lizhigang34098/FreeRTOS_UAV/Project_Step_Analysis/13.飞控定高.docx

## 1.1 移植官方文件到interface/fix_height

## 1.2 Vl53l1_platfrom.c

### #include "vl53l1_platform.h"

### #include <string.h>

### #include <time.h>

### #include <math.h>

### int8_t VL53L1_WriteMulti(uint16_t dev, uint16_t index, uint8_t *pdata, uint32_t count)

### {

### return 0; // to be implemented

### }

### int8_t VL53L1_ReadMulti(uint16_t dev, uint16_t index, uint8_t *pdata, uint32_t count)

### {

### return 0; // to be implemented

### }

### int8_t VL53L1_WrByte(uint16_t dev, uint16_t index, uint8_t data)

### {

### // 只写入一个字节

### HAL_I2C_Mem_Write(&hi2c2, dev, index, I2C_MEMADD_SIZE_16BIT, &data, 1, 1000);

### return 0; // to be implemented

### }

### int8_t VL53L1_WrWord(uint16_t dev, uint16_t index, uint16_t data)

### {

### uint8_t data_buf[2] = {0};

### // 使用大端序

### data_buf[0] = data >> 8;

### data_buf[1] = data & 0xFF;

### HAL_I2C_Mem_Write(&hi2c2, dev, index, I2C_MEMADD_SIZE_16BIT, data_buf, 2, 1000);

### return 0; // to be implemented

### }

### int8_t VL53L1_WrDWord(uint16_t dev, uint16_t index, uint32_t data)

### {

### uint8_t data_buf[4] = {0};

### // 使用大端序

### data_buf[0] = data >> 24;

### data_buf[1] = (data >> 16) & 0xFF;

### data_buf[2] = (data >> 8) & 0xFF;

### data_buf[3] = data & 0xFF;

### HAL_I2C_Mem_Write(&hi2c2, dev, index, I2C_MEMADD_SIZE_16BIT, data_buf, 4, 1000);

### return 0; // to be implemented

### }

### int8_t VL53L1_RdByte(uint16_t dev, uint16_t index, uint8_t *data)

### {

### HAL_I2C_Mem_Read(&hi2c2, dev, index, I2C_MEMADD_SIZE_16BIT, data, 1, 1000);

### return 0; // to be implemented

### }

### int8_t VL53L1_RdWord(uint16_t dev, uint16_t index, uint16_t *data)

### {

### // 读取的数据是大端序的

### uint8_t data_buf[2] = {0};

### HAL_I2C_Mem_Read(&hi2c2, dev, index, I2C_MEMADD_SIZE_16BIT, data_buf, 2, 1000);

### *data = (data_buf[0] << 8) | data_buf[1];

### return 0; // to be implemented

### }

### int8_t VL53L1_RdDWord(uint16_t dev, uint16_t index, uint32_t *data)

### {

### uint8_t data_buf[4] = {0};

### HAL_I2C_Mem_Read(&hi2c2, dev, index, I2C_MEMADD_SIZE_16BIT, data_buf, 4, 1000);

### *data = (data_buf[0] << 24) | (data_buf[1] << 16) | (data_buf[2] << 8) | data_buf[3];

### return 0; // to be implemented

### }

### int8_t VL53L1_WaitMs(uint16_t dev, int32_t wait_ms)

### {

### return 0; // to be implemented

### }

## 1.3 Int_VL53L1X.h

### #ifndef __INT_VL53L1X__

### #define __INT_VL53L1X__

### #include "vl53l1_platform.h"

### #include "VL53L1X_api.h"

### #include "VL53L1X_calibration.h"

### #include "FreeRTOS.h"

### #include "task.h"

### /**

### * @brief 初始化激光测距仪 完成寄存器的配置

### */

### void Int_VL53L1X_Init(void);

### /**

### * @brief 读取激光测距仪的距离值

### */

### uint16_t Int_VL53L1X_GetDistance(void);

### #endif // __INT_VL53L1X__

## 1.4 Int_VL53L1X.c

### #include "Int_VL53L1X.h"

### uint16_t dev = 0x52;

### /**

### * @brief 初始化激光测距仪 完成寄存器的配置

### */

### void Int_VL53L1X_Init(void)

### {

### // 1. 重置芯片 => XSHUT引脚拉低再拉高

### HAL_GPIO_WritePin(VX_XSHUT_GPIO_Port, VX_XSHUT_Pin, GPIO_PIN_RESET);

### vTaskDelay(2);

### HAL_GPIO_WritePin(VX_XSHUT_GPIO_Port, VX_XSHUT_Pin, GPIO_PIN_SET);

### vTaskDelay(2);

### uint8_t byteData = 0;

### uint16_t wordData = 0;

### uint8_t sensorState = 0;

### /* Those basic I2C read functions can be used to check your own I2C functions */

### VL53L1_RdByte(dev, 0x010F, &byteData);

### printf("VL53L1X Model_ID: %X\n", byteData);

### VL53L1_RdByte(dev, 0x0110, &byteData);

### printf("VL53L1X Module_Type: %X\n", byteData);

### VL53L1_RdWord(dev, 0x010F, &wordData);

### printf("VL53L1X: %X\n", wordData);

### while (sensorState == 0)

### {

### VL53L1X_BootState(dev, &sensorState);

### vTaskDelay(2);

### }

### printf("Chip booted\n");

### /* This function must to be called to initialize the sensor with the default setting */

### VL53L1X_SensorInit(dev);

### VL53L1X_SetDistanceMode(dev, 2); /* 1=short, 2=long */

### VL53L1X_SetTimingBudgetInMs(dev, 20); /* in ms possible values [20, 50, 100, 200, 500] */

### VL53L1X_SetInterMeasurementInMs(dev, 20); /* in ms, IM must be > = TB */

### printf("VL53L1X Ultra Lite Driver Example running ...\n");

### VL53L1X_StartRanging(dev); /* This function has to be called to enable the ranging */

### }

### /**

### * @brief 读取激光测距仪的距离值

### */

### uint16_t Int_VL53L1X_GetDistance(void)

### {

### uint16_t Distance = 0;

### VL53L1X_GetDistance(dev, &Distance);

### return Distance;

### }

## 1.5 App_flight.h

## #ifndef __APP_FLIGHT__

## #define __APP_FLIGHT__

## #include "math.h"

## #include "Com_debug.h"

## #include "Com_pid.h"

## #include "Int_motor.h"

## #include "Int_VL53L1X.h"

## /**

## * @brief 根据PID的输出值 控制电机

## */

## void App_flight_control_motor(void);

## /**

## * @brief 进入定高功能之后的PID计算

## */

## void App_flight_fix_height_pid_process(void);

## #endif // __APP_FLIGHT__

## 1.6 App_flight.c

#include "App_flight.h"

extern Remote_Data remote_data;

extern Flight_State flight_state;

extern TaskHandle_t com_task_handle;

// 电机结构体

Motor_Struct left_top_motor = {.tim = &htim3, .channel = TIM_CHANNEL_1, .speed = 0};

Motor_Struct left_bottom_motor = {.tim = &htim4, .channel = TIM_CHANNEL_4, .speed = 0};

Motor_Struct right_top_motor = {.tim = &htim2, .channel = TIM_CHANNEL_2, .speed = 0};

Motor_Struct right_bottom_motor = {.tim = &htim1, .channel = TIM_CHANNEL_3, .speed = 0};

// 定高的PID结构体

PID_Struct height_pid = {.kp = -0.60, .ki = 0.00, .kd = -0.20};

// 记录下的定高飞行高度

extern uint16_t fix_height;

/**

* @brief 飞控任务初始化 MPU6050初始化 启动电机

*

*/

void App_flight_init(void)

{

Int_MPU6050_Init();

// 启动电机

Int_motor_start(&left_top_motor);

Int_motor_start(&left_bottom_motor);

Int_motor_start(&right_top_motor);

Int_motor_start(&right_bottom_motor);

// 初始化激光测距仪

Int_VL53L1X_Init();

}

/**

* @brief 根据PID的输出值 控制电机

*

*/

void App_flight_control_motor(void)

{

// 1. 首先判断当前飞机的飞行状态

switch (flight_state)

{

case FIX_HEIGHT:

// 只有定高状态才需要进行定高的PID计算 => 定高同时也需要平稳飞行

left_top_motor.speed = remote_data.thr + gyro_y_pid.output - gyro_x_pid.output + Com_limit(gyro_z_pid.output, 100, -100) + height_pid.output;

left_bottom_motor.speed = remote_data.thr - gyro_y_pid.output - gyro_x_pid.output - Com_limit(gyro_z_pid.output, 100, -100) + height_pid.output;

right_top_motor.speed = remote_data.thr + gyro_y_pid.output + gyro_x_pid.output - Com_limit(gyro_z_pid.output, 100, -100) + height_pid.output;

right_bottom_motor.speed = remote_data.thr - gyro_y_pid.output + gyro_x_pid.output + Com_limit(gyro_z_pid.output, 100, -100) + height_pid.output;

break;

case FAIL:

// 进行故障处理 => 一直处理 到满足条件 修改状态为IDLE

// 6ms => 降低速度2点

left_top_motor.speed -= 2;

left_bottom_motor.speed -= 2;

right_top_motor.speed -= 2;

right_bottom_motor.speed -= 2;

if (left_top_motor.speed <= 0 && left_bottom_motor.speed <= 0 && right_top_motor.speed <= 0 && right_bottom_motor.speed <= 0)

{

// 故障处理完成 电机转速都已经降低为0

xTaskNotifyGive(com_task_handle);

}

break;

default:

break;

}

/**

* @brief 进入定高功能之后的PID计算

*

*/

void App_flight_fix_height_pid_process(void)

{

// 24ms一次

// 1. 填写目标值(按下定高功能时的高度)和测量值(当前激光测距仪得到的高度)

height_pid.desire = fix_height;

height_pid.measure = Int_VL53L1X_GetDistance();

// 2. 进行单环PID计算 得到输出值

Com_PID_Calc(&height_pid);

}

## 1.7 App_receive_data.c

### // 按下定高之后的飞行高度

### extern uint16_t fix_height;

### /**

### * @brief 处理飞机的飞行状态

### */

### void App_process_flight_state(void)

### {

### // 使用状态机逻辑实现

### // 1. 轮询调用判断当前所处的状态

### switch (flight_state)

### {

### case NORMAL:

### // 3. 判断进入定高

### if (remote_data.fix_height == 1)

### {

### flight_state = FIX_HEIGHT;

### remote_data.fix_height = 0;

### // 记录下当前目标的高度

### fix_height = Int_VL53L1X_GetDistance();

### }

### // 4. 判断进入故障失联状态

### if (remote_state == REMOTE_DISCONNECTED)

### {

### flight_state = FAIL;

### }

### break;

### case FIX_HEIGHT:

### // 5. 取消定高

### if (remote_data.fix_height == 1)

### {

### flight_state = NORMAL;

### remote_data.fix_height = 0;

### }

### // 6. 判断故障

### if (remote_state == REMOTE_DISCONNECTED)

### {

### flight_state = FAIL;

### }

### break;

### case FAIL:

### // 7.处理失联故障 缓慢停止电机

### // 等待故障处理完成 => 一直等处理完成 不会出现超时

### ulTaskNotifyTake(pdTRUE, portMAX_DELAY);

### flight_state = IDLE;

### break;

### default:

### break;

### }

### }

## 1.8 App_freeRTOS_Task.c

### void flight_task(void *args)

### {

### // 获取当前的基准时间

### TickType_t xLastWakeTime = xTaskGetTickCount();

### uint8_t count = 0;

### // 一定要先对MPU6050执行初始化操作 => 之后才能读取数据

### App_flight_init();

### while (1)

### {

### // 判断定高

### if (flight_state == FIX_HEIGHT)

### {

### // 才需要计算PID => 激光测距仪的数据采集 20ms一次

### count++;

### if (count >= 4)

### {

### App_flight_fix_height_pid_process();

### count = 0;

### }

### }

### // 根据PID计算的结果 对电机进行控制

### App_flight_control_motor();

### // // 4. 打印激光测距仪得到的距离值

### // uint16_t distance = Int_VL53L1X_GetDistance();

### // debug_printf("distance:%d\r\n", distance);

### vTaskDelayUntil(&xLastWakeTime, FLIGHT_TASK_PERIOD);

### }

### }
