lizhigang34098/FreeRTOS_UAV/Project_Step_Analysis/12.飞控pid控制.docx

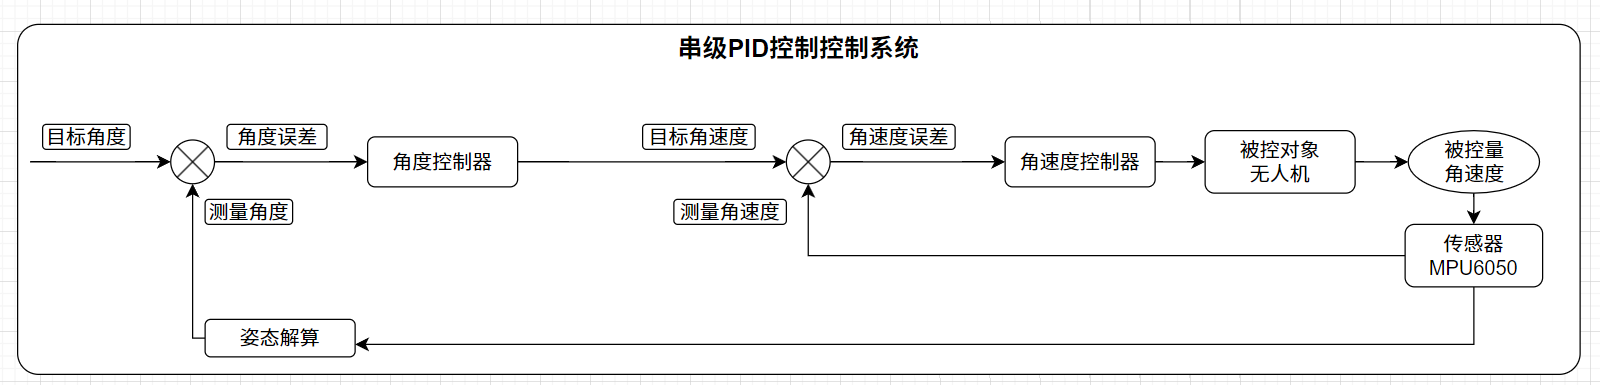
[picture p1: figure]

## 1.1 Com_pid.h

### #ifndef __COM_PID__

### #define __COM_PID__

### #include "main.h"

### #define PID_PERIOD 0.006

### // PID结构体 如果CPU性能够强 推荐使用double

### // kp,ki,kd需要在初始化时确定 目标值和测量值 需要在计算时传递

### typedef struct

### {

### float kp; // 比例部分 值越大响应速度越快

### float ki; // 积分部分 解决稳态误差 无人机控制中 积分项一般不使用

### float kd; // 微分部分 值越大 抑制效果越好 解决过调震荡

### float err; // 误差值

### float desire; // 目标值

### float measure; // 测量值

### float last_err; // 上一次的误差

### float integral; // 积分累积

### float output; // 输出结果

### } PID_Struct;

### // 单次PID计算

### void Com_PID_Calc(PID_Struct *pid);

### // 串级PID计算

### void Com_PID_Calc_Chain(PID_Struct *out_pid, PID_Struct *in_pid);\

### /**

### * @brief 限制数值在正常的范围内

### *

### * @param speed

### * @param max_speed

### * @param min_speed

### * @return int16_t

### */

### int16_t Com_limit(int16_t speed, int16_t max_speed,int16_t min_speed);

### #endif // __COM_PID__

## 1.2 Com_pid.c

### #include "Com_pid.h"

### // 单次PID计算

### void Com_PID_Calc(PID_Struct *pid)

### {

### // 1. 目标和测量 => 计算误差值

### pid->err = pid->measure - pid->desire;

### // 2. 计算积分误差

### pid->integral += pid->err;

### if (pid->last_err == 0)

### {

### pid->last_err = pid->err;

### }

### // 3. 计算微分误差

### float der = pid->err - pid->last_err;

### // 4. 计算输出

### pid->output = pid->kp * pid->err + (pid->ki * pid->integral * PID_PERIOD) + (pid->kd * der / PID_PERIOD);

### // 5. 保存上一次误差

### pid->last_err = pid->err;

### }

### // 串级PID计算

### void Com_PID_Calc_Chain(PID_Struct *out_pid, PID_Struct *in_pid)

### {

### // 1.先计算外环

### Com_PID_Calc(out_pid);

### // 2.将外环的输出值作为内环的目标值

### in_pid->desire = out_pid->output;

### // 3. 计算内环

### Com_PID_Calc(in_pid);

### }

### /**

### * @brief 限制数值在正常的范围内

### *

### * @param speed

### * @param max_speed

### * @param min_speed

### * @return int16_t

### */

### int16_t Com_limit(int16_t speed, int16_t max_speed, int16_t min_speed)

### {

### if (speed > max_speed)

### {

### return max_speed;

### }

### else if (speed < min_speed)

### {

### return min_speed;

### }

### return speed;

### }

## 1.3 App_flight.h

### #ifndef __APP_FLIGHT__

### #define __APP_FLIGHT__

### #include "math.h"

### #include "Com_debug.h"

### #include "Com_filter.h"

### #include "Com_imu.h"

### #include "Com_pid.h"

### #include "Int_motor.h"

### #include "Int_mpu6050.h"

### /**

### * @brief 飞控任务初始化 MPU6050初始化 启动电机

### */

### void App_flight_init(void);

### /**

### * @brief 根据陀螺仪测量的数据 计算出欧拉角

### *

### */

### void App_flight_get_euler_angle(void);

### /**

### * @brief 根据欧拉角 计算出PID的目标值

### */

### void App_flight_pid_process(void);

### /**

### * @brief 根据PID的输出值 控制电机

### */

### void App_flight_control_motor(void);

### #endif // __APP_FLIGHT__

## 1.4 App_flight.c

### #include "App_flight.h"

### Gyro_Accel_Struct gyro_accel_data = {0};

### Euler_struct euler_angle = {0};

### Gyro_struct last_gyro = {0};

### float gyro_z_sum = 0;

### extern Remote_Data remote_data;

### extern Flight_State flight_state;

### // 电机结构体

### Motor_Struct left_top_motor = {.tim = &htim3, .channel = TIM_CHANNEL_1, .speed = 0};

### Motor_Struct left_bottom_motor = {.tim = &htim4, .channel = TIM_CHANNEL_4, .speed = 0};

### Motor_Struct right_top_motor = {.tim = &htim2, .channel = TIM_CHANNEL_2, .speed = 0};

### Motor_Struct right_bottom_motor = {.tim = &htim1, .channel = TIM_CHANNEL_3, .speed = 0};

### // PID的调参是先调节内环再调节外环

### // 俯仰角PID结构体 => 后续需要进行专业的PID调参

### PID_Struct pitch_pid = {.kp = -7.00, .ki = 0.00, .kd = 0.00};

### // Y轴角速度结构体 => 对应俯仰角的内环

### // 极性问题 => 参数的正负可以调节 => 作用于电机的时候 正负

### PID_Struct gyro_y_pid = {.kp = 3.00, .ki = 0.00, .kd = 0.50};

### // 横滚角PID结构体

### PID_Struct roll_pid = {.kp = -7.00, .ki = 0.00, .kd = 0.00};

### // X轴角速度结构体 => 对应横滚角角的内环

### PID_Struct gyro_x_pid = {.kp = 3.00, .ki = 0.00, .kd = 0.50};

### /**

### * @brief 飞控任务初始化 MPU6050初始化 启动电机

### *

### */

### void App_flight_init(void)

### {

### Int_MPU6050_Init();

### // 启动电机

### Int_motor_start(&left_top_motor);

### Int_motor_start(&left_bottom_motor);

### Int_motor_start(&right_top_motor);

### Int_motor_start(&right_bottom_motor);

### }

### /**

### * @brief 根据欧拉角 计算出PID的目标值

### *

### */

### void App_flight_pid_process(void)

### {

### // 俯仰角

### // 1. 需要赋值目标值和测量值

### // 外环的目标角度 => 如果是平稳飞行 => 值为0 => 如果需要遥控飞行 => 目标角度就是遥控器的值

### // 数值转换 => remote_data.pit(0-1000,500为中间点) 控制范围在±10°

### pitch_pid.desire = (remote_data.pit - 500) / 50.0;

### // 内环的测量值 => 就是当前的俯仰角

### pitch_pid.measure = euler_angle.pitch;

### // 外环的测量值 => 当前的角速度 => 单位要保持一致

### gyro_y_pid.measure = (gyro_accel_data.gyro.gyro_y * 2000.0 / 32768.0);

### // 2. 进行PID计算

### Com_PID_Calc_Chain(&pitch_pid, &gyro_y_pid);

### // 先观察内环 => 角速度控制 => 目标位角速度为0

### // debug_printf(":%.2f,%.2f\n", gyro_y_pid.err, gyro_y_pid.output);

### // 横滚角

### // 1. 需要赋值目标值和测量值

### // 外环的目标角度 => 如果是平稳飞行 => 值为0 => 如果需要遥控飞行 => 目标角度就是遥控器的值

### roll_pid.desire = (remote_data.rol - 500) / 50.0;

### // 内环的测量值

### roll_pid.measure = euler_angle.roll;

### // 外环的测量值

### gyro_x_pid.measure = (gyro_accel_data.gyro.gyro_x * 2000.0 / 32768.0);

### // 2. 进行PID计算

### Com_PID_Calc_Chain(&roll_pid, &gyro_x_pid);

### }

### /**

### * @brief 根据PID的输出值 控制电机

### */

### void App_flight_control_motor(void)

### {

### // 1. 首先判断当前飞机的飞行状态

### switch (flight_state)

### {

### case IDLE:

### // 一旦进入加锁状态 => 需要将电机速度设置为0

### left_top_motor.speed = 0;

### left_bottom_motor.speed = 0;

### right_top_motor.speed = 0;

### right_bottom_motor.speed = 0;

### break;

### case NORMAL:

### // 俯仰角 => 向前飞有角速度 => 正误差 => 需要一个向后飞的反馈效果 => 前两个电机转的快 后两个转的慢

### left_top_motor.speed = remote_data.thr + gyro_y_pid.output - gyro_x_pid.output;

### left_bottom_motor.speed = remote_data.thr - gyro_y_pid.output - gyro_x_pid.output;

### right_top_motor.speed = remote_data.thr + gyro_y_pid.output + gyro_x_pid.output;

### right_bottom_motor.speed = remote_data.thr - gyro_y_pid.output + gyro_x_pid.output;

### break;

### case FIX_HEIGHT:

### break;

### case FAIL:

### break;

### default:

### break;

### }

### // 限制电机速度的上限值

### left_top_motor.speed = Com_limit(left_top_motor.speed, 600, 0);

### left_bottom_motor.speed = Com_limit(left_bottom_motor.speed, 600, 0);

### right_top_motor.speed = Com_limit(right_top_motor.speed, 600, 0);

### right_bottom_motor.speed = Com_limit(right_bottom_motor.speed, 600, 0);

### // 安全限制 => 当油门设置为<50时 => 强制将速度设置为0

### if (remote_data.thr < 50)

### {

### left_top_motor.speed = 0;

### left_bottom_motor.speed = 0;

### right_top_motor.speed = 0;

### right_bottom_motor.speed = 0;

### }

### // 2. 设置电机速度

### Int_motor_set_speed(&left_top_motor);

### Int_motor_set_speed(&left_bottom_motor);

### Int_motor_set_speed(&right_top_motor);

### Int_motor_set_speed(&right_bottom_motor);

### }

## 1.5 App_freeRTOS_Task.c

### #include "App_freeRTOS_Task.h"

### // 表示当前的飞行状态

### Flight_State flight_state = IDLE;

### /

### // 飞行控制任务

### void flight_task(void *args);

### #define FLIGHT_TASK_STACK_SIZE 128

### #define FLIGHT_TASK_PRIORITY 3

### TaskHandle_t flight_task_handle;

### #define FLIGHT_TASK_PERIOD 6

### /**

### * @brief 启动freeRTOS操作系统

### */

### void App_freeRTOS_start(void)

### {

### // 创建飞行控制任务

### xTaskCreate(flight_task, "flight_task", FLIGHT_TASK_STACK_SIZE, NULL, FLIGHT_TASK_PRIORITY, &flight_task_handle);

### // 启动调度器

### vTaskStartScheduler();

### }

### void flight_task(void *args)

### {

### // 获取当前的基准时间

### TickType_t xLastWakeTime = xTaskGetTickCount();

### // 一定要先对MPU6050执行初始化操作 => 之后才能读取数据

### App_flight_init();

### while (1)

### {

### // 1. 获根据MPU6050测量的数据 姿态解算得到欧拉角

### App_flight_get_euler_angle();

### // 2. 根据当前的欧拉角 进行PID计算控制

### App_flight_pid_process();

### // 3. 根据PID计算的结果 对电机进行控制

### App_flight_control_motor();

### vTaskDelayUntil(&xLastWakeTime, FLIGHT_TASK_PERIOD);

### }

### }
