lizhigang34098/FreeRTOS_UAV/Project_Step_Analysis/11.飞控任务获取飞行姿态.docx

# 第 1 章 Mpu6050采集数据

## 1.1 Com_config.h

### #ifndef _COM_CONFIG_H

### #define _COM_CONFIG_H

### #include "main.h"

### typedef struct

### {

### int16_t thr;

### int16_t yaw;

### int16_t pit;

### int16_t rol;

### uint8_t shutdown; // 1: 关闭 0: 不关机

### uint8_t fix_height; // 1. 切换定高和不定高 0: 不切换

### } Remote_Data;

### // 陀螺仪数据

### typedef struct

### {

### int16_t gyro_x; // 往右飞为正 表示横滚角

### int16_t gyro_y; // 向前飞转动为正 表示俯仰角

### int16_t gyro_z; // 逆时针转动为正 表示偏航角

### } Gyro_struct;

### typedef struct

### {

### int16_t accel_x; // 往前为正

### int16_t accel_y; // 往左为正

### int16_t accel_z; // 朝上的加速度为正

### } Accel_struct;

### typedef struct

### {

### Gyro_struct gyro;

### Accel_struct accel;

### } Gyro_Accel_Struct;

### // 解算得到的欧拉角

### typedef struct

### {

### int16_t yaw;

### int16_t pitch;

### int16_t roll;

### } Euler_struct;

### #endif // !_COM_CONFIG_H

## 1.2 Int_mpu6050.h

### #ifndef __INT_MPU6050__

### #define __INT_MPU6050__

### #include "i2c.h"

### #include "Com_config.h"

### #include "FreeRTOS.h"

### #include "task.h"

### #include "stdlib.h"

### // 从设备地址

### #define MPU6050_ADDR 0x68

### // 读写地址

### #define MPU6050_ADDR_WRITE 0xD0

### #define MPU6050_ADDR_READ 0xD1

### #define MPU_SELF_TESTX_REG 0X0D // 自检寄存器X

### #define MPU_SELF_TESTY_REG 0X0E // 自检寄存器Y

### #define MPU_SELF_TESTZ_REG 0X0F // 自检寄存器Z

### #define MPU_SELF_TESTA_REG 0X10 // 自检寄存器A

### #define MPU_SAMPLE_RATE_REG 0X19 // 采样频率分频器

### #define MPU_CFG_REG 0X1A // 配置寄存器

### #define MPU_GYRO_CFG_REG 0X1B // 陀螺仪配置寄存器

### #define MPU_ACCEL_CFG_REG 0X1C // 加速度计配置寄存器

### #define MPU_MOTION_DET_REG 0X1F // 运动检测阀值设置寄存器

### #define MPU_FIFO_EN_REG 0X23 // FIFO使能寄存器

### #define MPU_I2CMST_CTRL_REG 0X24 // IIC主机控制寄存器

### #define MPU_I2CSLV0_ADDR_REG 0X25 // IIC从机0器件地址寄存器

### #define MPU_I2CSLV0_REG 0X26 // IIC从机0数据地址寄存器

### #define MPU_I2CSLV0_CTRL_REG 0X27 // IIC从机0控制寄存器

### #define MPU_I2CSLV1_ADDR_REG 0X28 // IIC从机1器件地址寄存器

### #define MPU_I2CSLV1_REG 0X29 // IIC从机1数据地址寄存器

### #define MPU_I2CSLV1_CTRL_REG 0X2A // IIC从机1控制寄存器

### #define MPU_I2CSLV2_ADDR_REG 0X2B // IIC从机2器件地址寄存器

### #define MPU_I2CSLV2_REG 0X2C // IIC从机2数据地址寄存器

### #define MPU_I2CSLV2_CTRL_REG 0X2D // IIC从机2控制寄存器

### #define MPU_I2CSLV3_ADDR_REG 0X2E // IIC从机3器件地址寄存器

### #define MPU_I2CSLV3_REG 0X2F // IIC从机3数据地址寄存器

### #define MPU_I2CSLV3_CTRL_REG 0X30 // IIC从机3控制寄存器

### #define MPU_I2CSLV4_ADDR_REG 0X31 // IIC从机4器件地址寄存器

### #define MPU_I2CSLV4_REG 0X32 // IIC从机4数据地址寄存器

### #define MPU_I2CSLV4_DO_REG 0X33 // IIC从机4写数据寄存器

### #define MPU_I2CSLV4_CTRL_REG 0X34 // IIC从机4控制寄存器

### #define MPU_I2CSLV4_DI_REG 0X35 // IIC从机4读数据寄存器

### #define MPU_I2CMST_STA_REG 0X36 // IIC主机状态寄存器

### #define MPU_INTBP_CFG_REG 0X37 // 中断/旁路设置寄存器

### #define MPU_INT_EN_REG 0X38 // 中断使能寄存器

### #define MPU_INT_STA_REG 0X3A // 中断状态寄存器

### #define MPU_ACCEL_XOUTH_REG 0X3B // 加速度值,X轴高8位寄存器

### #define MPU_ACCEL_XOUTL_REG 0X3C // 加速度值,X轴低8位寄存器

### #define MPU_ACCEL_YOUTH_REG 0X3D // 加速度值,Y轴高8位寄存器

### #define MPU_ACCEL_YOUTL_REG 0X3E // 加速度值,Y轴低8位寄存器

### #define MPU_ACCEL_ZOUTH_REG 0X3F // 加速度值,Z轴高8位寄存器

### #define MPU_ACCEL_ZOUTL_REG 0X40 // 加速度值,Z轴低8位寄存器

### #define MPU_TEMP_OUTH_REG 0X41 // 温度值高八位寄存器

### #define MPU_TEMP_OUTL_REG 0X42 // 温度值低8位寄存器

### #define MPU_GYRO_XOUTH_REG 0X43 // 陀螺仪值,X轴高8位寄存器

### #define MPU_GYRO_XOUTL_REG 0X44 // 陀螺仪值,X轴低8位寄存器

### #define MPU_GYRO_YOUTH_REG 0X45 // 陀螺仪值,Y轴高8位寄存器

### #define MPU_GYRO_YOUTL_REG 0X46 // 陀螺仪值,Y轴低8位寄存器

### #define MPU_GYRO_ZOUTH_REG 0X47 // 陀螺仪值,Z轴高8位寄存器

### #define MPU_GYRO_ZOUTL_REG 0X48 // 陀螺仪值,Z轴低8位寄存器

### #define MPU_I2CSLV0_DO_REG 0X63 // IIC从机0数据寄存器

### #define MPU_I2CSLV1_DO_REG 0X64 // IIC从机1数据寄存器

### #define MPU_I2CSLV2_DO_REG 0X65 // IIC从机2数据寄存器

### #define MPU_I2CSLV3_DO_REG 0X66 // IIC从机3数据寄存器

### #define MPU_I2CMST_DELAY_REG 0X67 // IIC主机延时管理寄存器

### #define MPU_SIGPATH_RST_REG 0X68 // 信号通道复位寄存器

### #define MPU_MDETECT_CTRL_REG 0X69 // 运动检测控制寄存器

### #define MPU_USER_CTRL_REG 0X6A // 用户控制寄存器

### #define MPU_PWR_MGMT1_REG 0X6B // 电源管理寄存器1

### #define MPU_PWR_MGMT2_REG 0X6C // 电源管理寄存器2

### #define MPU_FIFO_CNTH_REG 0X72 // FIFO计数寄存器高八位

### #define MPU_FIFO_CNTL_REG 0X73 // FIFO计数寄存器低八位

### #define MPU_FIFO_RW_REG 0X74 // FIFO读写寄存器

### #define MPU_DEVICE_ID_REG 0X75 // 器件ID寄存器

### /**

### * @brief 初始化MPU6050芯片

### *

### */

### void Int_MPU6050_Init(void);

### /**

### * @brief 读取三轴角速度

### *

### * @param gyro

### */

### void Int_MPU6050_Get_Gyro(Gyro_struct *gyro);

### /**

### * @brief 读取三轴加速度

### *

### * @param acc

### */

### void Int_MPU6050_Get_Acc(Accel_struct *acc);

### /**

### * @brief 获取所有的六轴数据

### *

### * @param data

### */

### void Int_MPU6050_Get_Data(Gyro_Accel_Struct *data);

### #endif // __INT_MPU6050__

## 1.3 Int_mpu6050.c

### #include "Int_mpu6050.h"

### // 保存偏移量的值

### int32_t acc_x_offset = 0;

### int32_t acc_y_offset = 0;

### int32_t acc_z_offset = 0;

### int32_t gyro_x_offset = 0;

### int32_t gyro_y_offset = 0;

### int32_t gyro_z_offset = 0;

### /**

### * @brief 写寄存器

### *

### * @param reg 寄存器地址

### * @param data 寄存器的值

### */

### void Int_MPU6050_Write_Reg(uint8_t reg, uint8_t data)

### {

### // HAL有固定的I2C读写函数

### // 1. 句柄(hi2c1) 2. 从设备地址(0x68) 3. 寄存器地址 reg 4. 寄存器地址的位数 5. 写入的数据地址 6. 写入的字节个数 7. 超时时间

### HAL_I2C_Mem_Write(&hi2c1, MPU6050_ADDR_WRITE, reg, I2C_MEMADD_SIZE_8BIT, &data, 1, 1000);

### }

### void Int_MPU6050_Read_Reg(uint8_t reg, uint8_t *data)

### {

### // 1. 句柄(hi2c1) 2. 从设备地址(0x68) 3. 寄存器地址 reg 4. 寄存器地址的位数 5. 存放读取数据的地址 6. 读的字节个数 7. 超时时间

### HAL_I2C_Mem_Read(&hi2c1, MPU6050_ADDR_READ, reg, I2C_MEMADD_SIZE_8BIT, data, 1, 1000);

### }

### /**

### * @brief 在初始化MPU6050完成之后 对MPU6050进行零偏校准

### *

### */

### void Int_MPU6050_calculate_offset(void)

### {

### // 1. 等待飞机停放平稳

### // 判断飞机是否停放平稳的标准: 前后两次加速度的值差值小于200 连续100次

### Accel_struct current_accel = {0}; // 当前读取的加速度值

### Accel_struct last_accel = {0}; // 上一次读取的加速度值

### uint8_t count = 0;

### Int_MPU6050_Get_Acc(&last_accel);

### while (count < 100)

### {

### Int_MPU6050_Get_Acc(&current_accel);

### // 判断飞机是否平稳 选用的参数过小 会造成一直无法判断为平稳

### if (abs(current_accel.accel_x - last_accel.accel_x) < 400 && abs(current_accel.accel_y - last_accel.accel_y) < 400 && abs(current_accel.accel_z - last_accel.accel_z) < 400)

### {

### count++;

### }

### else

### {

### count = 0;

### }

### last_accel = current_accel;

### vTaskDelay(6);

### }

### // 2. 飞机已经平稳 开始进行零偏校准

### Gyro_Accel_Struct gyro_accel_data = {0};

### int32_t acc_x_sum = 0;

### int32_t acc_y_sum = 0;

### int32_t acc_z_sum = 0;

### int32_t gyro_x_sum = 0;

### int32_t gyro_y_sum = 0;

### int32_t gyro_z_sum = 0;

### for (uint8_t i = 0; i < 100; i++)

### {

### // 重新读取加速度和角速度

### Int_MPU6050_Get_Data(&gyro_accel_data);

### acc_x_sum += (gyro_accel_data.accel.accel_x - 0);

### acc_y_sum += (gyro_accel_data.accel.accel_y - 0);

### // Z轴加速度的初始化应该就是1g => 量程是±2g => 16384

### acc_z_sum += (gyro_accel_data.accel.accel_z - 16384);

### gyro_x_sum += (gyro_accel_data.gyro.gyro_x - 0);

### gyro_y_sum += (gyro_accel_data.gyro.gyro_y - 0);

### gyro_z_sum += (gyro_accel_data.gyro.gyro_z - 0);

### // 每次测量数据需要添加延迟 多次测量取平均值才有意义

### vTaskDelay(6);

### }

### acc_x_offset = acc_x_sum / 100;

### acc_y_offset = acc_y_sum / 100;

### acc_z_offset = acc_z_sum / 100;

### gyro_x_offset = gyro_x_sum / 100;

### gyro_y_offset = gyro_y_sum / 100;

### gyro_z_offset = gyro_z_sum / 100;

### }

### /**

### * @brief 初始化MPU6050芯片

### *

### */

### void Int_MPU6050_Init(void)

### {

### // 1. 重启芯片 重置所有寄存器的值 => 写电源管理寄存器1 => DEVICE_RESET

### Int_MPU6050_Write_Reg(0x6B, 0x80);

### uint8_t data = 0;

### // 重置完成之后 0x6B寄存器的值是0x40 表示当前为低功耗模式

### while (data != 0x40)

### {

### Int_MPU6050_Read_Reg(0x6B, &data);

### }

### // 唤醒MPU6050 进入到正常工作状态

### Int_MPU6050_Write_Reg(0x6B, 0x00);

### // 2. 选择合适的量程 => 在够用的范围内 选择的越小越好 => 精度高

### // 2.1 填写角速度量程为±2000°/s

### Int_MPU6050_Write_Reg(0x1B, 3 << 3);

### // 2.2 填写加速度量程为±2g

### Int_MPU6050_Write_Reg(0x1C, 0x00);

### // 3. 关闭中断使能 因为用不到中断

### Int_MPU6050_Write_Reg(0x38, 0x00);

### // 4. 用户配置寄存器 不使用FIFO队列 不使用扩展的I2C

### Int_MPU6050_Write_Reg(0x6A, 0x00);

### // 5. 设置采样频率 => 陀螺仪监控三轴加速度和三轴角速度 => 默认频率 1000HZ => 1ms读取一次

### // 基本逻辑 => 采样率必须大于后续数据的使用频率 否则失真 => 香农定理 采样率 >= 2倍使用频率

### // 设置采样分频为2 => 填写的值就是2-1

### Int_MPU6050_Write_Reg(0x19, 0x01);

### // 6. 设置低通滤波的值为184Hz 188Hz => 1

### Int_MPU6050_Write_Reg(0x1A, 1);

### // 7. 配置使用的系统时钟为添加PLL的

### Int_MPU6050_Write_Reg(0x6B, 0x01);

### // 8. 使能加速度传感器和角速度传感器

### Int_MPU6050_Write_Reg(0x6C, 0x00);

### // 9. 进行零偏校准

### Int_MPU6050_calculate_offset();

### }

### /**

### * @brief 读取三轴角速度 => 需要进行零偏校准 => 本身抖动不严重

### *

### * @param gyro

### */

### void Int_MPU6050_Get_Gyro(Gyro_struct *gyro)

### {

### // 存储角速度的寄存器地址从0x43开始 高8位在前 XYZ的顺序

### uint8_t hight = 0;

### uint8_t low = 0;

### // X轴

### Int_MPU6050_Read_Reg(MPU_GYRO_XOUTH_REG, &hight);

### Int_MPU6050_Read_Reg(MPU_GYRO_XOUTL_REG, &low);

### gyro->gyro_x = (hight << 8 | low) - gyro_x_offset;

### // Y轴

### Int_MPU6050_Read_Reg(MPU_GYRO_YOUTH_REG, &hight);

### Int_MPU6050_Read_Reg(MPU_GYRO_YOUTL_REG, &low);

### gyro->gyro_y = (hight << 8 | low) - gyro_y_offset;

### // Z轴

### Int_MPU6050_Read_Reg(MPU_GYRO_ZOUTH_REG, &hight);

### Int_MPU6050_Read_Reg(MPU_GYRO_ZOUTL_REG, &low);

### gyro->gyro_z = (hight << 8 | low) - gyro_z_offset;

### }

### /**

### * @brief 读取三轴加速度 抖动比较严重 需要零偏校准 Z轴值不为0

### *

### * @param acc

### */

### void Int_MPU6050_Get_Acc(Accel_struct *acc)

### {

### uint8_t hight = 0;

### uint8_t low = 0;

### // X轴

### Int_MPU6050_Read_Reg(MPU_ACCEL_XOUTH_REG, &hight);

### Int_MPU6050_Read_Reg(MPU_ACCEL_XOUTL_REG, &low);

### acc->accel_x = (hight << 8 | low) - acc_x_offset;

### // Y轴

### Int_MPU6050_Read_Reg(MPU_ACCEL_YOUTH_REG, &hight);

### Int_MPU6050_Read_Reg(MPU_ACCEL_YOUTL_REG, &low);

### acc->accel_y = (hight << 8 | low) - acc_y_offset;

### // Z轴

### Int_MPU6050_Read_Reg(MPU_ACCEL_ZOUTH_REG, &hight);

### Int_MPU6050_Read_Reg(MPU_ACCEL_ZOUTL_REG, &low);

### acc->accel_z = (hight << 8 | low) - acc_z_offset;

### }

### /**

### * @brief 获取所有的六轴数据

### *

### * @param data

### */

### void Int_MPU6050_Get_Data(Gyro_Accel_Struct *data)

### {

### Int_MPU6050_Get_Gyro(&data->gyro);

### Int_MPU6050_Get_Acc(&data->accel);

### }

## 1.4 App_flight.h

### #ifndef __APP_FLIGHT__

### #define __APP_FLIGHT__

### #include "Int_mpu6050.h"

### #include "Com_debug.h"

### /**

### * @brief 根据陀螺仪测量的数据 计算出欧拉角

### *

### */

### void App_flight_get_euler_angle(void);

### #endif // __APP_FLIGHT__

## 1.5 App_flight.c

### #include "App_flight.h"

### Gyro_Accel_Struct gyro_accel_data = {0};

### Euler_struct euler_angle = {0};

### /**

### * @brief 根据陀螺仪测量的数据 计算出欧拉角

### *

### */

### void App_flight_get_euler_angle(void)

### {

### // 1. 使用MPU6050的硬件接口 得到六轴数据

### Int_MPU6050_Get_Data(&gyro_accel_data);

### // 先打印角速度

### // debug_printf(":%d,%d,%d\n", gyro_accel_data.gyro.gyro_x, gyro_accel_data.gyro.gyro_y, gyro_accel_data.gyro.gyro_z);

### // 打印加速度

### debug_printf(":%d,%d,%d\n",gyro_accel_data.accel.accel_x, gyro_accel_data.accel.accel_y, gyro_accel_data.accel.accel_z);

### }

## 1.6 App_freeRTOS_Task.c

### void flight_task(void *args)

### {

### // 获取当前的基准时间

### TickType_t xLastWakeTime = xTaskGetTickCount();

### // 一定要先对MPU6050执行初始化操作 => 之后才能读取数据

### Int_MPU6050_Init();

### while (1)

### {

### // 1. 获取三轴加速度和三轴角速度

### App_flight_get_euler_angle();

### vTaskDelayUntil(&xLastWakeTime, FLIGHT_TASK_PERIOD);

### }

### }

# 第 2 章 角速度低通滤波处理数据

## 2.1 Com_flight.h

### #ifndef __COMMON_FILTER_H

### #define __COMMON_FILTER_H

### #include "Com_debug.h"

### int16_t Common_Filter_LowPass(int16_t newValue, int16_t preFilteredValue);

### #endif

## 2.2 Com_flight.c

## #include "Com_filter.h"

## // 新值的系数 值越小 低通滤波的效果越强

## #define ALPHA 0.15 /* 一阶低通滤波 指数加权系数 */

## /**

## * @description: 一阶低通滤波

## * 是一种常用的滤波器，用于去除高频噪声或高频成分，保留信号中的低频成分。

## * 在单片机应用中，一种简单且常见的低通滤波器是一阶无限脉冲响应（IIR）低通滤波器，

## * 通常实现为指数加权移动平均滤波器。

## * @param {int16_t} newValue 需要滤波的值

## * @param {int16_t} preFilteredValue 上一次滤波过的值

## * @return {*}

## */

## int16_t Common_Filter_LowPass(int16_t newValue, int16_t preFilteredValue)

## {

## return ALPHA * newValue + (1 - ALPHA) * preFilteredValue;

## }

## 2.3 App_flight.c

### /**

### * @brief 根据陀螺仪测量的数据 计算出欧拉角

### *

### */

### void App_flight_get_euler_angle(void)

### {

### // 1. 使用MPU6050的硬件接口 得到六轴数据

### Int_MPU6050_Get_Data(&gyro_accel_data);

### // 2. 对角速度进行低通滤波 => 后续对采集数据的使用是及时性比较高的

### // 对准确性要求没那么高 但是一定要计算迅速

### // output = 加权系数 * last_output + ( 1 - 加权系数 )* 本次的测量值;

### gyro_accel_data.gyro.gyro_x = Common_Filter_LowPass(gyro_accel_data.gyro.gyro_x, last_gyro.gyro_x);

### gyro_accel_data.gyro.gyro_y = Common_Filter_LowPass(gyro_accel_data.gyro.gyro_y, last_gyro.gyro_y);

### gyro_accel_data.gyro.gyro_z = Common_Filter_LowPass(gyro_accel_data.gyro.gyro_z, last_gyro.gyro_z);

### last_gyro.gyro_x = gyro_accel_data.gyro.gyro_x;

### last_gyro.gyro_y = gyro_accel_data.gyro.gyro_y;

### last_gyro.gyro_z = gyro_accel_data.gyro.gyro_z;

### // 打印角速度

### debug_printf(":%d,%d,%d\n", gyro_accel_data.gyro.gyro_x, gyro_accel_data.gyro.gyro_y, gyro_accel_data.gyro.gyro_z);

### }

# 第 3 章 加速度卡尔曼滤波处理数据

## 3.1 Com_flight.h

### #ifndef __COMMON_FILTER_H

### #define __COMMON_FILTER_H

### #include "Com_debug.h"

### /* 卡尔曼滤波器结构体 */

### typedef struct

### {

### float LastP; // 上一时刻的状态方差（或协方差）

### float Now_P; // 当前时刻的状态方差（或协方差）

### float out; // 滤波器的输出值，即估计的状态

### float Kg; // 卡尔曼增益，用于调节预测值和测量值之间的权重

### float Q; // 过程噪声的方差，反映系统模型的不确定性

### float R; // 测量噪声的方差，反映测量过程的不确定性

### } KalmanFilter_Struct;

### extern KalmanFilter_Struct kfs[3];

### double Common_Filter_KalmanFilter(KalmanFilter_Struct *kf, double input);

### #endif

## 3.2 Com_flight.c

### #include "Com_filter.h"

### /* 卡尔曼滤波 https://www.mwrf.net/tech/basic/2023/30081.html

### https://www.kalmanfilter.net/CN/default_cn.aspx*/

### /* 卡尔曼滤波参数 */

### KalmanFilter_Struct kfs[3] = {

### {0.02, 0, 0, 0, 0.001, 0.543},

### {0.02, 0, 0, 0, 0.001, 0.543},

### {0.02, 0, 0, 0, 0.001, 0.543}};

### double Common_Filter_KalmanFilter(KalmanFilter_Struct *kf, double input)

### {

### kf->Now_P = kf->LastP + kf->Q;

### kf->Kg = kf->Now_P / (kf->Now_P + kf->R);

### kf->out = kf->out + kf->Kg * (input - kf->out);

### kf->LastP = (1 - kf->Kg) * kf->Now_P;

### return kf->out;

### }

## 3.3 App_flight.c

### /**

### * @brief 根据陀螺仪测量的数据 计算出欧拉角

### *

### */

### void App_flight_get_euler_angle(void)

### {

### // 使用MPU6050的硬件接口 得到六轴数据

### Int_MPU6050_Get_Data(&gyro_accel_data);

### // 对波动变化比较大的加速度 使用更高级的滤波方式 => 卡尔曼滤波

### gyro_accel_data.accel.accel_x = Common_Filter_KalmanFilter(&kfs[0], gyro_accel_data.accel.accel_x);

### gyro_accel_data.accel.accel_y = Common_Filter_KalmanFilter(&kfs[1], gyro_accel_data.accel.accel_y);

### gyro_accel_data.accel.accel_z = Common_Filter_KalmanFilter(&kfs[2], gyro_accel_data.accel.accel_z);

### // 打印加速度

### debug_printf(":%d,%d,%d\n", gyro_accel_data.accel.accel_x, gyro_accel_data.accel.accel_y, gyro_accel_data.accel.accel_z);

### }

# 第 4 章 互补解算计算欧拉角

## 4.1 App_flight.c

/**

* @brief 根据陀螺仪测量的数据 计算出欧拉角

*

*/

void App_flight_get_euler_angle(void)

{

// 1. 使用MPU6050的硬件接口 得到六轴数据

Int_MPU6050_Get_Data(&gyro_accel_data);

// 2. 对角速度进行低通滤波 => 后续对采集数据的使用是及时性比较高的

// 对准确性要求没那么高 但是一定要计算迅速

// output = 加权系数 * last_output + ( 1 - 加权系数 )* 本次的测量值;

gyro_accel_data.gyro.gyro_x = Common_Filter_LowPass(gyro_accel_data.gyro.gyro_x, last_gyro.gyro_x);

gyro_accel_data.gyro.gyro_y = Common_Filter_LowPass(gyro_accel_data.gyro.gyro_y, last_gyro.gyro_y);

gyro_accel_data.gyro.gyro_z = Common_Filter_LowPass(gyro_accel_data.gyro.gyro_z, last_gyro.gyro_z);

last_gyro.gyro_x = gyro_accel_data.gyro.gyro_x;

last_gyro.gyro_y = gyro_accel_data.gyro.gyro_y;

last_gyro.gyro_z = gyro_accel_data.gyro.gyro_z;

// 先打印角速度

// debug_printf(":%d,%d,%d\n", gyro_accel_data.gyro.gyro_x, gyro_accel_data.gyro.gyro_y, gyro_accel_data.gyro.gyro_z);

// 3. 对波动变化比较大的加速度 使用更高级的滤波方式 => 卡尔曼滤波

gyro_accel_data.accel.accel_x = Common_Filter_KalmanFilter(&kfs[0], gyro_accel_data.accel.accel_x);

gyro_accel_data.accel.accel_y = Common_Filter_KalmanFilter(&kfs[1], gyro_accel_data.accel.accel_y);

gyro_accel_data.accel.accel_z = Common_Filter_KalmanFilter(&kfs[2], gyro_accel_data.accel.accel_z);

// 打印加速度

// debug_printf(":%d,%d,%d\n", gyro_accel_data.accel.accel_x, gyro_accel_data.accel.accel_y, gyro_accel_data.accel.accel_z);

// 4. 通过加速度和角速度来计算当前飞机切斜的角度 => 姿态解算

// 使用互补解算计算欧拉角 => 优先使用加速度解算 => 俯仰角和横滚角能够使用

euler_angle.pitch = atan2(gyro_accel_data.accel.accel_x * 1.0, gyro_accel_data.accel.accel_z) / 3.14159 * 180;

euler_angle.roll = atan2(gyro_accel_data.accel.accel_y * 1.0, gyro_accel_data.accel.accel_z) / 3.14159 * 180;

// // 偏航角 => 只能使用角速度积分

// // 16位ADC的值转换为°/s => 量程是±2000°/s

gyro_z_sum += (gyro_accel_data.gyro.gyro_z * 2000.0 / 32768.0) * 0.006;

// euler_angle.yaw = gyro_z_sum;

// 俯仰角 横滚角 偏航角

debug_printf(":%.2f,%.2f,%.2f\n", euler_angle.pitch, euler_angle.roll, euler_angle.yaw);

}

# 第 5 章 四元数姿态解算

# /**

# * @brief 根据陀螺仪测量的数据 计算出欧拉角

# *

# */

# void App_flight_get_euler_angle(void)

# {

# // 1. 使用MPU6050的硬件接口 得到六轴数据

# Int_MPU6050_Get_Data(&gyro_accel_data);

# // 2. 对角速度进行低通滤波 => 后续对采集数据的使用是及时性比较高的

# // 对准确性要求没那么高 但是一定要计算迅速

# // output = 加权系数 * last_output + ( 1 - 加权系数 )* 本次的测量值;

# gyro_accel_data.gyro.gyro_x = Common_Filter_LowPass(gyro_accel_data.gyro.gyro_x, last_gyro.gyro_x);

# gyro_accel_data.gyro.gyro_y = Common_Filter_LowPass(gyro_accel_data.gyro.gyro_y, last_gyro.gyro_y);

# gyro_accel_data.gyro.gyro_z = Common_Filter_LowPass(gyro_accel_data.gyro.gyro_z, last_gyro.gyro_z);

# last_gyro.gyro_x = gyro_accel_data.gyro.gyro_x;

# last_gyro.gyro_y = gyro_accel_data.gyro.gyro_y;

# last_gyro.gyro_z = gyro_accel_data.gyro.gyro_z;

# // 先打印角速度

# // debug_printf(":%d,%d,%d\n", gyro_accel_data.gyro.gyro_x, gyro_accel_data.gyro.gyro_y, gyro_accel_data.gyro.gyro_z);

# // 3. 对波动变化比较大的加速度 使用更高级的滤波方式 => 卡尔曼滤波

# gyro_accel_data.accel.accel_x = Common_Filter_KalmanFilter(&kfs[0], gyro_accel_data.accel.accel_x);

# gyro_accel_data.accel.accel_y = Common_Filter_KalmanFilter(&kfs[1], gyro_accel_data.accel.accel_y);

# gyro_accel_data.accel.accel_z = Common_Filter_KalmanFilter(&kfs[2], gyro_accel_data.accel.accel_z);

# // 打印加速度

# // debug_printf(":%d,%d,%d\n", gyro_accel_data.accel.accel_x, gyro_accel_data.accel.accel_y, gyro_accel_data.accel.accel_z);

# // 也可以使用移植的四元数姿态解算

# Common_IMU_GetEulerAngle(&gyro_accel_data, &euler_angle, 0.006);

# // 俯仰角 横滚角 偏航角

# debug_printf(":%.2f,%.2f,%.2f\n", euler_angle.pitch, euler_angle.roll, euler_angle.yaw);

# }
