lizhigang34098/FreeRTOS_UAV/Project_Step_Analysis/8.遥控器采集数据处理.docx

## 1.1 App_process_data.h

### #ifndef __APP_PROCESS_DATA__

### #define __APP_PROCESS_DATA__

### #include "Int_joystick.h"

### #include "Int_key.h"

### #include "Com_debug.h"

### #include "Com_tool.h"

### typedef struct

### {

### int16_t thr;

### int16_t yaw;

### int16_t pit;

### int16_t rol;

### uint8_t shutdown; // 1: 关闭 0: 不关机

### uint8_t fix_height; // 1. 切换定高和不定高 0: 不切换

### } Remote_Data;

### /**

### * @brief 处理按键数据 => 如果有按键按下 需要进行对应的记录

### *

### */

### void App_process_key_data(void);

### /**

### * @brief 处理摇杆数据 => 修正极性相位和标准值

### *

### */

### void App_process_joystick_data(void);

### #endif // __APP_PROCESS_DATA__

## 1.2 App_process_data.c

### #include "App_process_data.h"

### // 摇杆数据结构体

### Joystick_Struct joystick = {0};

### Remote_Data remote_data = {0};

### // 区分一下摇杆的控制值和按键的微调值

### int16_t key_pit_offset = 0; // 往前飞是正

### int16_t key_roll_offset = 0; // 往右飞是正

### // 记录摇杆偏移量

### int16_t thr_offset = 0;

### int16_t yaw_offset = 0;

### int16_t pit_offset = 0;

### int16_t rol_offset = 0;

### // 校准摇杆函数

### void App_calibrate_joystick(void)

### {

### // 零偏校准的逻辑就是减去零偏的值

### // 首先清空掉按键的微调值

### key_pit_offset = 0;

### key_roll_offset = 0;

### // 多次读取求平均值

### int16_t thr_sum = 0;

### int16_t yaw_sum = 0;

### int16_t pit_sum = 0;

### int16_t rol_sum = 0;

### for (uint8_t i = 0; i < 10; i++)

### {

### App_process_joystick_data();

### thr_sum += joystick.thr - 0;

### yaw_sum += joystick.yaw - 500;

### pit_sum += joystick.pit - 500;

### rol_sum += joystick.rol - 500;

### vTaskDelay(10);

### }

### // 零偏校准的偏移值没有累加的效果 会造成两次校准退回的情况

### thr_offset += thr_sum / 10;

### yaw_offset += yaw_sum / 10;

### pit_offset += pit_sum / 10;

### rol_offset += rol_sum / 10;

### }

### /**

### * @brief 如果freeRTOS的两个任务优先级相等 => 两个任务会交替运行

### *

### */

### /**

### * @brief 处理按键数据 => 如果有按键按下 需要进行对应的记录

### *

### */

### void App_process_key_data(void)

### {

### Key_type key = Int_key_get();

### // 根据按键的值进行记录 => 如果进行摇杆的校准 => 将按键的值调整为0

### if (key == KEY_UP)

### {

### // 向前飞微调 => 俯仰角+

### key_pit_offset += 10;

### }

### else if (key == KEY_DOWN)

### {

### // 向后飞微调 => 俯仰角-

### key_pit_offset -= 10;

### }

### else if (key == KEY_LEFT)

### {

### key_roll_offset -= 10;

### }

### else if (key == KEY_RIGHT)

### {

### key_roll_offset += 10;

### }

### else if (key == KEY_LEFT_X)

### {

### remote_data.shutdown = 1;

### }

### else if (key == KEY_RIGHT_X)

### {

### remote_data.fix_height = 1;

### }

### else if (key == KEY_RIGHT_X_LONG)

### {

### // 校准摇杆 => 等到摇杆写完之后才知道怎么校准

### // 触发校准之后 摇杆的值THR为0 YAW PIT ROL 为500

### App_calibrate_joystick();

### }

### }

### /**

### * @brief 处理摇杆数据 => 修正极性相位和标准值

### *

### */

### void App_process_joystick_data(void)

### {

### // 如何解决freeRTOS的任务切换问题

### // 使用临界区解决

### taskENTER_CRITICAL();

### // 1. 获取摇杆监控的ADC值

### Int_joystick_get(&joystick);

### // 理论上 摇杆的任务运行到这一行 有可能跳转到按键任务的 => 会出现按键任务使用的摇杆数据没有经过处理

### // 2. 处理范围和极性 想要使用的范围值0-1000 => ADC的范围是0-4095

### joystick.thr = 1000 - (joystick.thr * 1000 / 4095);

### joystick.yaw = 1000 - (joystick.yaw * 1000 / 4095);

### joystick.pit = 1000 - (joystick.pit * 1000 / 4095);

### joystick.rol = 1000 - (joystick.rol * 1000 / 4095);

### // 3. 处理零偏校准

### joystick.thr -= thr_offset;

### joystick.yaw -= yaw_offset;

### joystick.pit -= pit_offset;

### joystick.rol -= rol_offset;

### // 4. 考虑按键的微调值

### joystick.pit += key_pit_offset;

### joystick.rol += key_roll_offset;

### // 5. 计算上偏移值可能超出范围 => 限制在0-1000

### joystick.thr = Com_limit(joystick.thr, 0, 1000);

### joystick.yaw = Com_limit(joystick.yaw, 0, 1000);

### joystick.pit = Com_limit(joystick.pit, 0, 1000);

### joystick.rol = Com_limit(joystick.rol, 0, 1000);

### // 退出临界区

### taskEXIT_CRITICAL();

### // 将处理完成的数据赋值给遥控数据

### remote_data.thr = joystick.thr;

### remote_data.yaw = joystick.yaw;

### remote_data.pit = joystick.pit;

### remote_data.rol = joystick.rol;

### // debug_printf(":%d,%d,%d,%d\n", joystick.thr, joystick.yaw, joystick.pit, joystick.rol);

### }

## 1.3 Com_tool.h

### #ifndef __COM_TOOL__

### #define __COM_TOOL__

### #include "main.h"

### /**

### * @brief 限幅函数

### *

### * @param value

### * @param min

### * @param max

### * @return int16_t

### */

### int16_t Com_limit(int16_t value, int16_t min, int16_t max);

### #endif // __COM_TOOL__

## 1.4 Com_tool.c

### #include "Com_tool.h"

### /**

### * @brief 限幅函数

### *

### * @param value

### * @param min

### * @param max

### * @return int16_t

### */

### int16_t Com_limit(int16_t value, int16_t min, int16_t max)

### {

### int16_t result = value;

### if (value > max)

### {

### result = max;

### }

### else if (value < min)

### {

### result = min;

### }

### return result;

### }

## 1.5 App_freeRTOS_Task.h

### #ifndef __APP_FREERTOS_TASK__

### #define __APP_FREERTOS_TASK__

### #include "FreeRTOS.h"

### #include "task.h"

### #include "Com_debug.h"

### #include "Int_IP5305T.h"

### #include "Int_SI24R1.h"

### #include "App_process_data.h"

### /**

### * @brief 启动freeRTOS操作系统

### */

### void App_freeRTOS_start(void);

### #endif // __APP_FREERTOS_TASK__

## 1.6 App_freeRTOS_Task.c

### #include "App_freeRTOS_Task.h"

### // 按键任务

### void key_task(void *args);

### #define KEY_TASK_STACK_SIZE 128

### #define KEY_TASK_PRIORITY 2

### TaskHandle_t key_task_handle;

### // 任务周期

### #define KEY_TASK_PERIOD 20

### // 摇杆任务

### void joy_task(void *args);

### #define JOY_TASK_STACK_SIZE 128

### #define JOY_TASK_PRIORITY 2

### TaskHandle_t joy_task_handle;

### // 任务周期

### #define JOY_TASK_PERIOD 20

### /**

### * @brief 启动freeRTOS操作系统

### */

### void App_freeRTOS_start(void)

### {

### // 3. 按键任务

### xTaskCreate(key_task, "key_task", KEY_TASK_STACK_SIZE, NULL, KEY_TASK_PRIORITY, &key_task_handle);

### // 4. 摇杆任务

### xTaskCreate(joy_task, "joy_task", JOY_TASK_STACK_SIZE, NULL, JOY_TASK_PRIORITY, &joy_task_handle);

### // 5. 启动调度器

### vTaskStartScheduler();

### }

### void joy_task(void *args)

### {

### TickType_t xLastWakeTime = xTaskGetTickCount();

### // 1. 初始化摇杆ADC

### Int_joystick_init();

### while (1)

### {

### // 统一的处理方式

### App_process_joystick_data();

### vTaskDelayUntil(&xLastWakeTime, JOY_TASK_PERIOD);

### }

### }

### void key_task(void *args)

### {

### TickType_t xLastWakeTime = xTaskGetTickCount();

### while (1)

### {

### // 统一的处理方式

### App_process_key_data();

### vTaskDelayUntil(&xLastWakeTime, KEY_TASK_PERIOD);

### }

### }
