lizhigang34098/FreeRTOS_UAV/Project_Step_Analysis/9.遥控器发送与飞控接收数据.docx

# 第 1 章 遥控

## 1.1 App_transmit_data.h

### #ifndef __APP_TRANSMIT_DATA__

### #define __APP_TRANSMIT_DATA__

### #include "Int_SI24R1.h"

### #include "App_process_data.h"

### #include "FreeRTOS.h"

### #include "task.h"

### // 定义帧头校验的值

### #define FRAME_HEAD_CHECK_1 'c'

### #define FRAME_HEAD_CHECK_2 's'

### #define FRAME_HEAD_CHECK_3 'r'

### /**

### * @brief 自动切换SI24R1的模式 => 将采集完成的遥控数据打包发送到飞机

### *

### */

### void App_transmit_data(void);

### #endif // __APP_TRANSMIT_DATA__

## 1.2 App_transmit_data.h

### #include "App_transmit_data.h"

### extern Remote_Data remote_data;

### uint8_t transmit_buff[TX_PLOAD_WIDTH] = {0};

### /**

### * @brief 自动切换SI24R1的模式 => 将采集完成的遥控数据打包发送到飞机

### */

### void App_transmit_data(void)

### {

### // 1. 切换到发送模式

### Int_SI24R1_TX_Mode();

### // 2. 发送数据 => 唯一性和可靠性

### // (1) => 帧头校验指定发送给对应的设备 唯一性

### // (2) => 发送数据的结尾 => 添加检验和(将发送的数据累加得到的值添加到数据的末尾) 可靠性

### uint32_t sum = 0;

### // 帧头校验设置为3字节 => 数据本身是10字节 => 校验和设置为4字节

### transmit_buff[0] = FRAME_HEAD_CHECK_1;

### transmit_buff[1] = FRAME_HEAD_CHECK_2;

### transmit_buff[2] = FRAME_HEAD_CHECK_3;

### // 高8位在前

### transmit_buff[3] = (remote_data.thr >> 8) & 0xFF;

### transmit_buff[4] = remote_data.thr & 0xFF;

### transmit_buff[5] = (remote_data.yaw >> 8) & 0xFF;

### transmit_buff[6] = remote_data.yaw & 0xFF;

### transmit_buff[7] = (remote_data.pit >> 8) & 0xFF;

### transmit_buff[8] = remote_data.pit & 0xFF;

### transmit_buff[9] = (remote_data.rol >> 8) & 0xFF;

### transmit_buff[10] = remote_data.rol & 0xFF;

### // 此处的关机和定高其实是会有0或1

### taskENTER_CRITICAL();

### transmit_buff[11] = remote_data.shutdown;// 正好在此处运行完成之后切换任务

### remote_data.shutdown = 0; // 此时shutdown=1 但是上一行代码没有记录下来

### transmit_buff[12] = remote_data.fix_height;

### remote_data.fix_height = 0;

### taskEXIT_CRITICAL();

### for (uint8_t i = 0; i < 13; i++)

### {

### sum += transmit_buff[i];

### }

### // 高位在前

### transmit_buff[13] = (sum >> 24) & 0xFF;

### transmit_buff[14] = (sum >> 16) & 0xFF;

### transmit_buff[15] = (sum >> 8) & 0xFF;

### transmit_buff[16] = sum & 0xFF;

### debug_printf(":%d,%d,%d,%d,%d,%d\n",remote_data.thr,remote_data.yaw,remote_data.pit,remote_data.rol,remote_data.shutdown,remote_data.fix_height);

### Int_SI24R1_TxPacket(transmit_buff);

### // 3. 切换回接收模式

### Int_SI24R1_RX_Mode();

### }

## 1.3 App_freeRTOS_Task.h

### #ifndef __APP_FREERTOS_TASK__

### #define __APP_FREERTOS_TASK__

### #include "FreeRTOS.h"

### #include "task.h"

### #include "Com_debug.h"

### #include "Int_IP5305T.h"

### #include "Int_SI24R1.h"

### #include "App_process_data.h"

### #include "App_transmit_data.h"

### /**

### * @brief 启动freeRTOS操作系统

### *

### */

### void App_freeRTOS_start(void);

### #endif // __APP_FREERTOS_TASK__

## 1.4 App_freeRTOS_Task.c

### #include "App_freeRTOS_Task.h"

### // 通讯任务

### void com_task(void *args);

### #define COM_TASK_STACK_SIZE 128

### #define COM_TASK_PRIORITY 3

### TaskHandle_t com_task_handle;

### // 任务周期

### #define COM_TASK_PERIOD 6

### /**

### * @brief 启动freeRTOS操作系统

### */

### void App_freeRTOS_start(void)

### {

### // 创建通讯任务

### xTaskCreate(com_task, "com_task", COM_TASK_STACK_SIZE, NULL, COM_TASK_PRIORITY, &com_task_handle);

### // 启动调度器

### vTaskStartScheduler();

### }

### void com_task(void *args)

### {

### // 获取当前的基准时间

### TickType_t xLastWakeTime = xTaskGetTickCount();

### while (1)

### {

### // 将打包完成的数据发送到飞机

### App_transmit_data();

### // 6ms执行一次

### vTaskDelayUntil(&xLastWakeTime, COM_TASK_PERIOD);

### }

### }

# 第 2 章 飞控

## 2.1 Com_config.h

### #ifndef _COM_CONFIG_H

### #define _COM_CONFIG_H

### #include "main.h"

### // 连接状态

### typedef enum

### {

### REMOTE_CONNECTED = 0,

### REMOTE_DISCONNECTED,

### }Remote_State;

### // 飞行状态

### typedef enum

### {

### IDLE = 0,

### NORMAL,

### FIX_HEIGHT,

### FAIL,

### }Flight_State;

### typedef struct

### {

### int16_t thr;

### int16_t yaw;

### int16_t pit;

### int16_t rol;

### uint8_t shutdown; // 1: 关闭 0: 不关机

### uint8_t fix_height; // 1. 切换定高和不定高 0: 不切换

### } Remote_Data;

### #endif // !_COM_CONFIG_H

## 2.2 App_receive.h

### #ifndef __APP_RECEIVE_DATA__

### #define __APP_RECEIVE_DATA__

### #include "Int_SI24R1.h"

### #include "Com_config.h"

### // 定义帧头校验的值

### #define FRAME_HEAD_CHECK_1 'c'

### #define FRAME_HEAD_CHECK_2 's'

### #define FRAME_HEAD_CHECK_3 'r'

### // 最大重试次数

### #define MAX_RETRY_TIMES 10

### /**

### * @brief 接收遥控器发送的遥控数据 => 解析为结构体

### *

### * @return uint8_t 0:校验通过 是正常的数据 1:没收到数据 或者 校验失败

### */

### uint8_t App_receive_data(void);

### /**

### * @brief 处理连接状态的状态

### *

### * @param res 上一次接收数据的返回值

### */

### void App_process_connect_state(uint8_t res);

### #endif // __APP_RECEIVE_DATA__

## 2.3 App_receive.c

### #include "App_receive_data.h"

### extern Remote_Data remote_data;

### uint8_t rx_buff[TX_PLOAD_WIDTH] = {0};

### extern Remote_State remote_state;

### // 重试次数

### uint8_t retry_count = 0;

### /**

### * @brief 接收遥控器发送的遥控数据 => 解析为结构体

### *

### * @return uint8_t 0:校验通过 是正常的数据 1:没收到数据 或者 校验失败

### */

### uint8_t App_receive_data(void)

### {

### memset(rx_buff, 0, TX_PLOAD_WIDTH);

### Int_SI24R1_RxPacket(rx_buff);

### if (strlen((char *)rx_buff) == 0)

### {

### return 1;

### }

### // 1. 帧头校验

### if (rx_buff[0] != FRAME_HEAD_CHECK_1 || rx_buff[1] != FRAME_HEAD_CHECK_2 || rx_buff[2] != FRAME_HEAD_CHECK_3)

### {

### return 1;

### }

### // 2. 帧尾校验

### uint32_t sum = 0;

### uint32_t sum_receive = 0;

### for (uint8_t i = 0; i < 13; i++)

### {

### sum += rx_buff[i];

### }

### // 高位在前

### sum_receive = rx_buff[13] << 24 | rx_buff[14] << 16 | rx_buff[15] << 8 | rx_buff[16];

### if (sum != sum_receive)

### {

### return 1;

### }

### // 3. 保存数据

### remote_data.thr = (rx_buff[3] << 8) | rx_buff[4];

### remote_data.yaw = (rx_buff[5] << 8) | rx_buff[6];

### remote_data.pit = (rx_buff[7] << 8) | rx_buff[8];

### remote_data.rol = (rx_buff[9] << 8) | rx_buff[10];

### remote_data.shutdown = rx_buff[11];

### remote_data.fix_height = rx_buff[12];

### debug_printf(":%d,%d,%d,%d,%d,%d\n", remote_data.thr, remote_data.yaw, remote_data.pit, remote_data.rol, remote_data.shutdown, remote_data.fix_height);

### return 0;

### }

### /**

### * @brief 处理连接状态的状态

### *

### * @param res 上一次接收数据的返回值

### */

### void App_process_connect_state(uint8_t res)

### {

### if (res == 0)

### {

### // 接收数据成功一次 即为连接成功

### // 此处使用的全局变量 只有当前一个地方会修改 LED灯控任务当中是读取使用

### remote_state = REMOTE_CONNECTED;

### retry_count = 0;

### }

### else if (res == 1)

### {

### // 接收数据失败 即为

### retry_count++;

### if (retry_count >= MAX_RETRY_TIMES)

### {

### remote_state = REMOTE_DISCONNECTED;

### retry_count = 0;

### }

### }

### }

## 2.4 App_freeRTOS_Task.h

### #ifndef __APP_RECEIVE_DATA__

### #define __APP_RECEIVE_DATA__

### #include "Int_SI24R1.h"

### #include "Com_config.h"

### // 定义帧头校验的值

### #define FRAME_HEAD_CHECK_1 'c'

### #define FRAME_HEAD_CHECK_2 's'

### #define FRAME_HEAD_CHECK_3 'r'

### // 最大重试次数

### #define MAX_RETRY_TIMES 10

### /**

### * @brief 接收遥控器发送的遥控数据 => 解析为结构体

### *

### * @return uint8_t 0:校验通过 是正常的数据 1:没收到数据 或者 校验失败

### */

### uint8_t App_receive_data(void);

### /**

### * @brief 处理连接状态的状态

### *

### * @param res 上一次接收数据的返回值

### */

### void App_process_connect_state(uint8_t res);

### #endif // __APP_RECEIVE_DATA__

## 2.5 App_freeRTOS_Task.c

### #include "App_freeRTOS_Task.h"

### // LED结构体

### LED_Struct left_top_led = {.port = LED1_GPIO_Port, .pin = LED1_Pin};

### LED_Struct right_top_led = {.port = LED2_GPIO_Port, .pin = LED2_Pin};

### LED_Struct right_bottom_led = {.port = LED3_GPIO_Port, .pin = LED3_Pin};

### LED_Struct left_bottom_led = {.port = LED4_GPIO_Port, .pin = LED4_Pin};

### // 表示当前连接状态

### Remote_State remote_state = REMOTE_DISCONNECTED;

### // 表示当前的飞行状态

### Flight_State flight_state = NORMAL;

### // 扩展获取接收的遥控数据

### Remote_Data remote_data = {0};

### // 电源管理任务

### void power_task(void *args);

### // 最小推荐填写128 => 128*4 = 512B

### #define POWER_TASK_STACK_SIZE 128

### // 任务优先级 => 数值越小 优先级越小 => 最大4 => 不推荐使用最小优先级0

### #define POWER_TASK_PRIORITY 4

### TaskHandle_t power_task_handle;

### // 定义任务的周期

### #define POWER_TASK_PERIOD 10000

### // 通讯任务

### void com_task(void *args);

### #define COM_TASK_STACK_SIZE 128

### #define COM_TASK_PRIORITY 2

### TaskHandle_t com_task_handle;

### // 任务周期

### #define COM_TASK_PERIOD 6

### /**

### * @brief 启动freeRTOS操作系统

### *

### */

### void App_freeRTOS_start(void)

### {

### // 创建电源管理任务

### xTaskCreate(power_task, "power_task", POWER_TASK_STACK_SIZE, NULL, POWER_TASK_PRIORITY, &power_task_handle);

### // 创建通讯任务

### xTaskCreate(com_task, "com_task", COM_TASK_STACK_SIZE, NULL, COM_TASK_PRIORITY, &com_task_handle);

### // 启动调度器

### vTaskStartScheduler();

### }

### void power_task(void *args)

### {

### // 获取当前的基准时间

### TickType_t xLastWakeTime = xTaskGetTickCount();

### while (1)

### {

### // // 每10s执行一次 => 启动电源 避免自动关机

### // vTaskDelayUntil(&xLastWakeTime, POWER_TASK_PERIOD);

### // // 启动电源

### // Int_IP5305T_start();

### // 使用直接任务通知的接收方法实现10s处理一次

### // 一直等任务通知 直到收到通知res=1 或者 超时res=0

### uint32_t res = ulTaskNotifyTake(pdTRUE, POWER_TASK_PERIOD);

### if (res != 0)

### {

### // 收到关机通知

### Int_IP5305T_shutdown();

### }

### else

### {

### // 不需要关机 => 正常执行启动

### Int_IP5305T_start();

### }

### }

### }

### void com_task(void *args)

### {

### // 获取当前的基准时间

### TickType_t xLastWakeTime = xTaskGetTickCount();

### while (1)

### {

### // 1. 接收数据

### uint8_t res = App_receive_data();

### // 2. 根据接收数据的返回值 处理当前飞机的连接状态

### App_process_connect_state(res);

### // 3. 处理关机命令

### if (remote_data.shutdown == 1)

### {

### // 使用Int_IP5305T_shutdown 关机 功能可以实现 但是项目结构比较奇怪

### // Int_IP5305T_shutdown();

### // 使用freeRTOS直接任务通知 => 通知电源任务 => 执行关机

### xTaskNotifyGive(power_task_handle);

### }

### // 6ms执行一次 接收数据的时间间隔应该等于发送数据的时间间隔

### vTaskDelayUntil(&xLastWakeTime, COM_TASK_PERIOD);

### }

### }
