lizhigang34098/FreeRTOS_UAV/Project_Step_Analysis/4.LED灯.docx

## 1.1 Com_config.h

### #ifndef _COM_CONFIG_H

### #define _COM_CONFIG_H

### #include "main.h"

### // 连接状态

### typedef enum

### {

### REMOTE_CONNECTED = 0,

### REMOTE_DISCONNECTED,

### }Remote_State;

### // 飞行状态

### typedef enum

### {

### IDLE = 0,

### NORMAL,

### FIX_HEIGHT,

### FAIL,

### }Flight_State;

### #endif // !_COM_CONFIG_H

## 1.2 Int_led.h

### #ifndef __INT_LED__

### #define __INT_LED__

### #include "main.h"

### typedef struct

### {

### GPIO_TypeDef *port;

### uint16_t pin;

### } LED_Struct;

### /**

### * @brief 打开LED灯

### * @param led

### */

### void Int_led_turn_on(LED_Struct *led);

### /**

### * @brief 关闭LED灯

### * @param led

### */

### void Int_led_turn_off(LED_Struct *led);

### /**

### * @brief 翻转LED灯

### * @param led

### */

### void Int_led_toggle(LED_Struct *led);

### #endif // __INT_LED__

## 1.3 Int_led.c

### #include "Int_led.h"

### /**

### * @brief 打开LED灯

### * @param led

### */

### void Int_led_turn_on(LED_Struct *led)

### {

### // 直接修改引脚电平为低电平 开灯

### HAL_GPIO_WritePin(led->port, led->pin, GPIO_PIN_RESET);

### }

### /**

### * @brief 关闭LED灯

### * @param led

### */

### void Int_led_turn_off(LED_Struct *led)

### {

### // 直接修改引脚电平为高电平 关灯

### HAL_GPIO_WritePin(led->port, led->pin, GPIO_PIN_SET);

### }

### /**

### * @brief 翻转LED灯

### * @param led

### */

### void Int_led_toggle(LED_Struct *led)

### {

### HAL_GPIO_TogglePin(led->port, led->pin);

### }

## 1.4 App_freeRTOS_Task.c

### #include "App_freeRTOS_Task.h"

### // LED结构体

### LED_Struct left_top_led = {.port = LED1_GPIO_Port, .pin = LED1_Pin};

### LED_Struct right_top_led = {.port = LED2_GPIO_Port, .pin = LED2_Pin};

### LED_Struct right_bottom_led = {.port = LED3_GPIO_Port, .pin = LED3_Pin};

### LED_Struct left_bottom_led = {.port = LED4_GPIO_Port, .pin = LED4_Pin};

### // 表示当前连接状态

### Remote_State remote_state = REMOTE_DISCONNECTED;

### // 表示当前的飞行状态

### Flight_State flight_state = NORMAL;

### // LED任务

### void led_task(void *args);

### #define LED_TASK_STACK_SIZE 128

### #define LED_TASK_PRIORITY 1

### TaskHandle_t led_task_handle;

### #define LED_TASK_PERIOD 100

### /**

### * @brief 启动freeRTOS操作系统

### */

### void App_freeRTOS_start(void)

### {

### // 创建LED灯任务

### xTaskCreate(led_task, "led_task", LED_TASK_STACK_SIZE, NULL, LED_TASK_PRIORITY, &led_task_handle);

### // 启动调度器

### vTaskStartScheduler();

### }

### void led_task(void *args)

### {

### // 获取当前的基准时间

### TickType_t xLastWakeTime = xTaskGetTickCount();

### uint8_t count = 0;

### while (1)

### {

### count++;

### // 前两个灯表示连接状态

### // 1. 判断当前连接状态

### if (remote_state == REMOTE_CONNECTED)

### {

### // 点亮前两个灯

### Int_led_turn_on(&left_top_led);

### Int_led_turn_on(&right_top_led);

### }

### else if (remote_state == REMOTE_DISCONNECTED)

### {

### // 关掉前两个灯

### Int_led_turn_off(&left_top_led);

### Int_led_turn_off(&right_top_led);

### }

### // 后两个灯表示飞行状态

### // 2. 判断当前飞行状态

### if (flight_state == IDLE)

### {

### // 灯慢闪烁 => 500ms亮 500ms灭

### if (count % 5 == 0)

### {

### // 循环5次 一次是100ms 5次等于500ms

### Int_led_toggle(&left_bottom_led);

### Int_led_toggle(&right_bottom_led);

### }

### }

### else if (flight_state == NORMAL)

### {

### // 灯快闪 => 200ms亮 200ms灭

### if (count % 2 == 0)

### {

### // 循环2次 一次是100ms 2次等于200ms

### Int_led_toggle(&left_bottom_led);

### Int_led_toggle(&right_bottom_led);

### }

### }

### else if (flight_state == FIX_HEIGHT)

### {

### // 后两个灯常量

### Int_led_turn_on(&left_bottom_led);

### Int_led_turn_on(&right_bottom_led);

### }

### else if (flight_state == FAIL)

### {

### // 后两个灯灭

### Int_led_turn_off(&left_bottom_led);

### Int_led_turn_off(&right_bottom_led);

### }

### // 将count计数重置

### if (count == 10)

### {

### count = 0;

### }

### vTaskDelayUntil(&xLastWakeTime, LED_TASK_PERIOD);

### }

### }
