lizhigang34098/FreeRTOS_UAV/Project_Step_Analysis/0.ubeMX配置操作.docx

无人机桨叶是倾斜的螺旋斜面，旋转方向只改变扭转力矩，不改变下压空气的效果。

四轴无人机的螺旋桨分两种：正桨、反桨

- Motor1/Motor3 逆时针转 → 配反桨
- Motor2/Motor4 顺时针转 → 配正桨

两种桨的倾斜斜面是镜像对称的，斜面朝向相反。

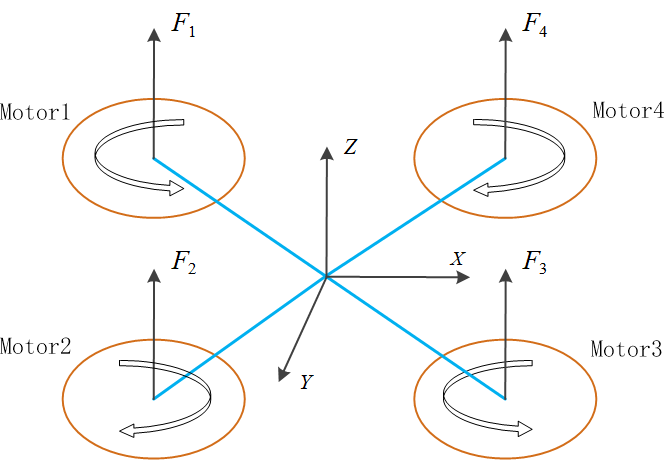
[picture p7: figure]

ISR中断服务程序

PendSV可挂起系统服务异常。Cortex-M 专门用来做任务上下文切换的异常；

设为最低优先级，是为了不让任务上下文切换切换抢占任何硬件中断，确保所有中断完整处理完，再执行任务切换，保障外设实时性与稳定性。

# CubeMx基础配置

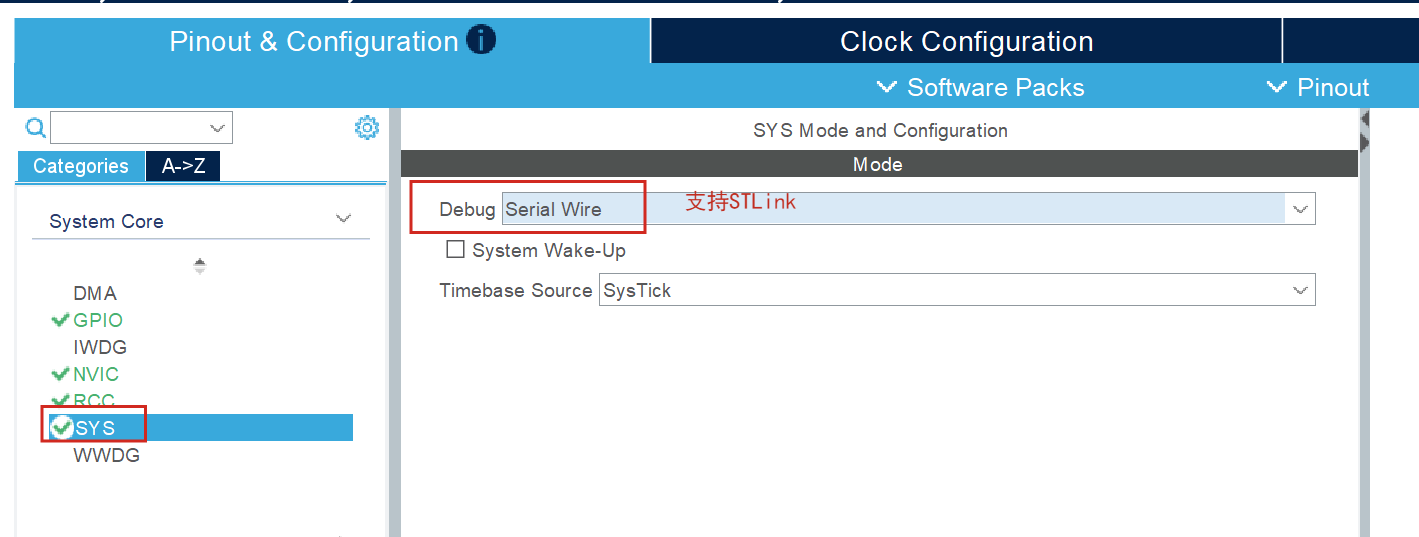
[picture p8: figure]
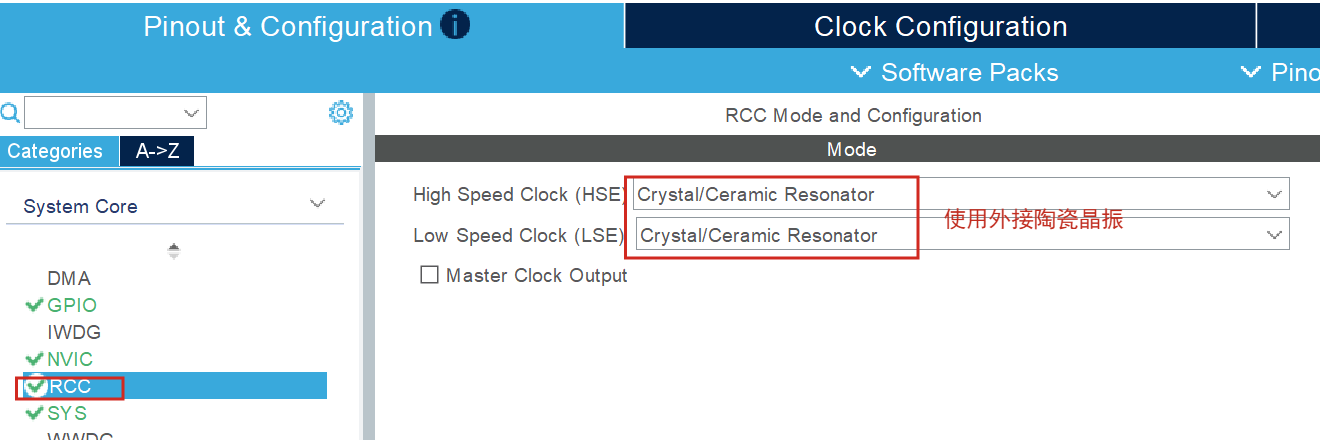
[picture p9: figure]
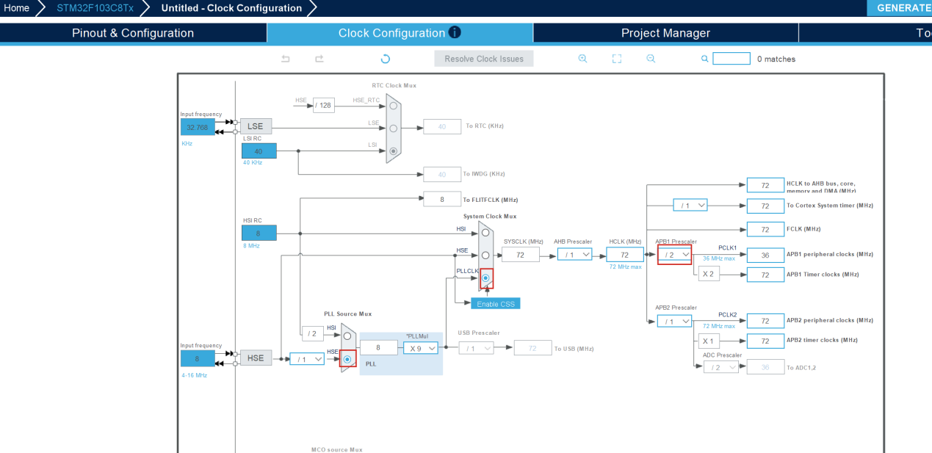
[picture p10: figure]

时钟树配置原理

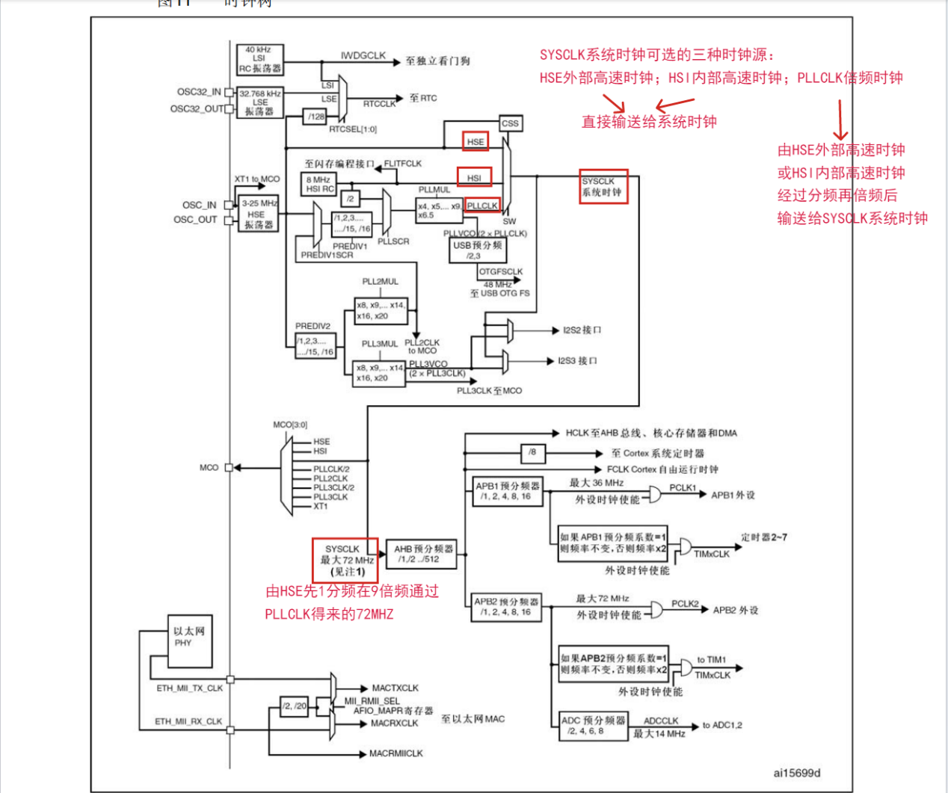
[picture p11: figure]
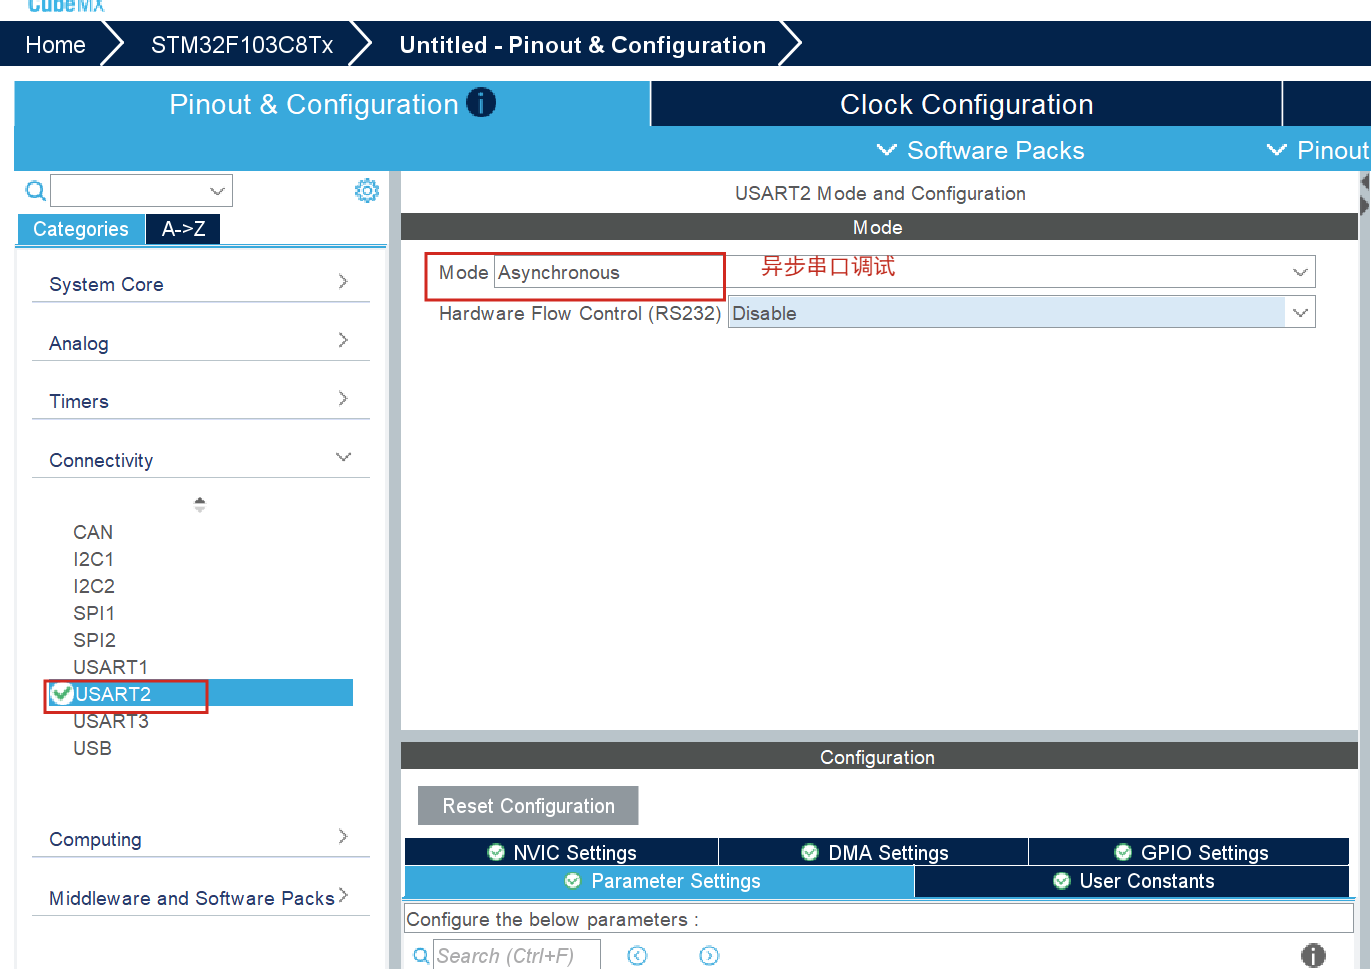
[picture p12: figure]
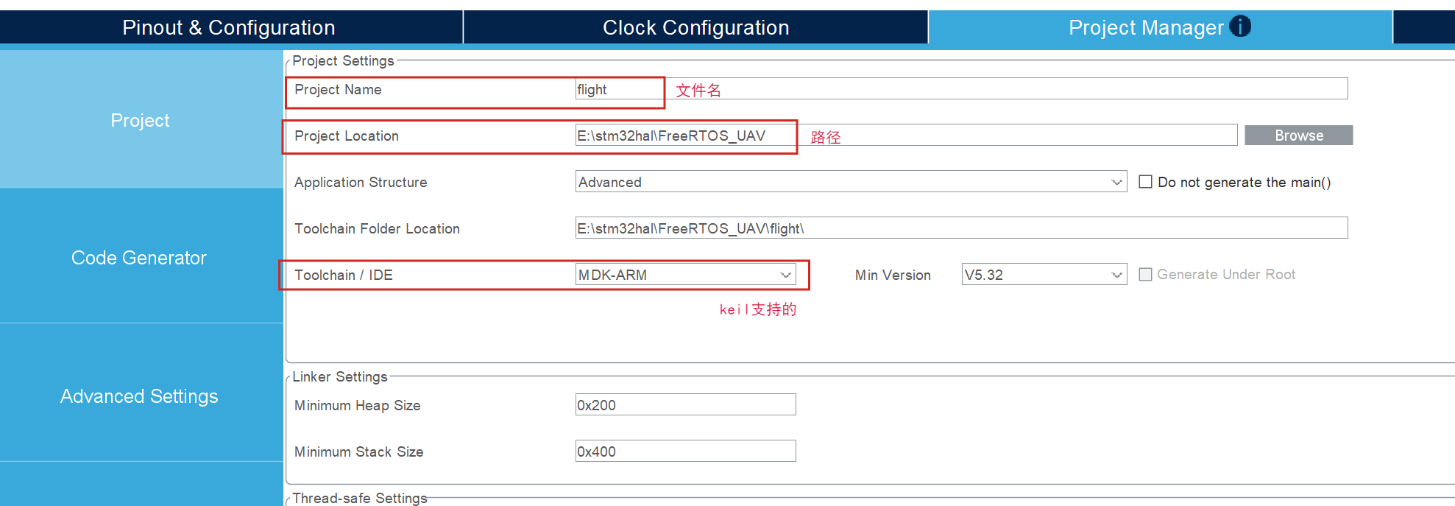
[picture p13: figure]
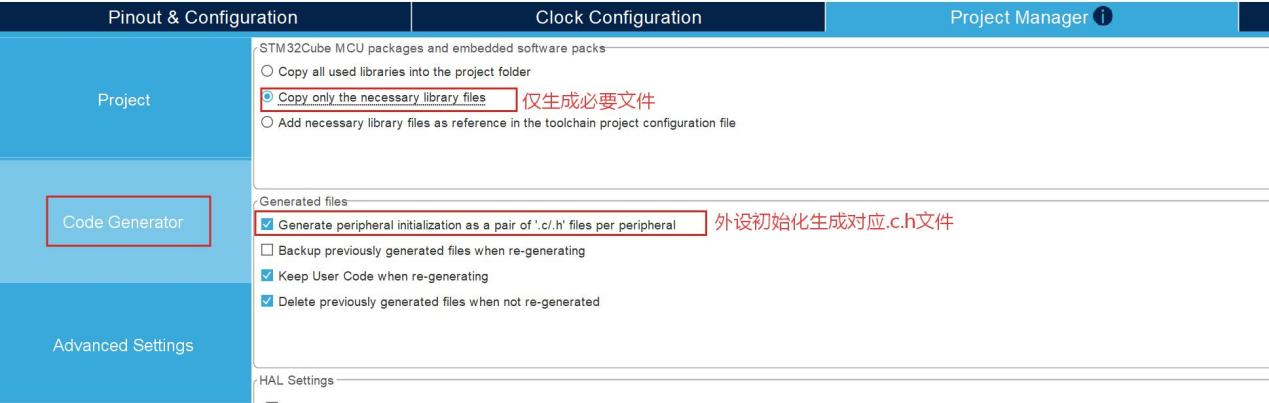
[picture p14: figure]
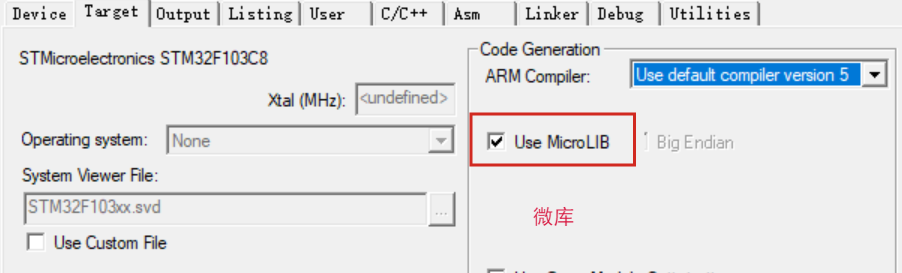
[picture p15: figure]
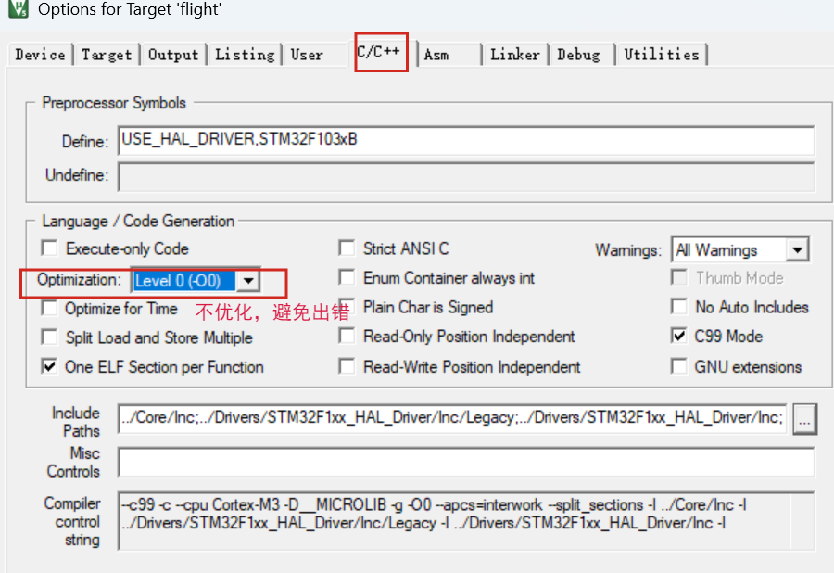
[picture p16: figure]
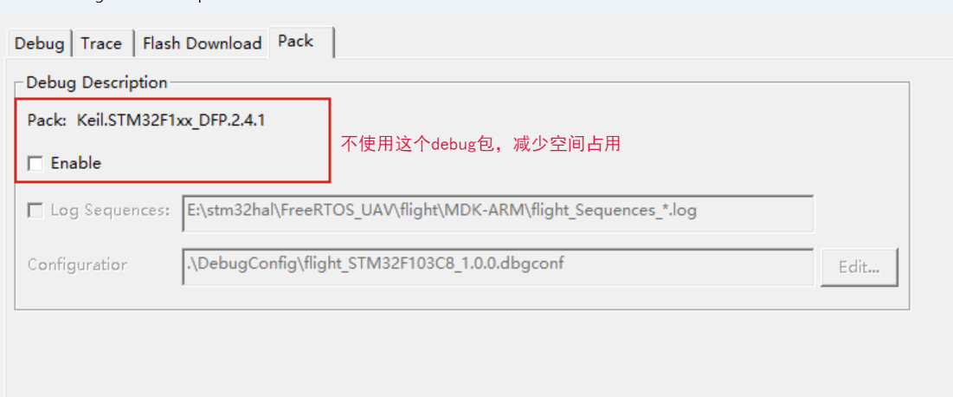
[picture p17: figure]

# 电源控制模块

## 配置CubeMX

电源原理图

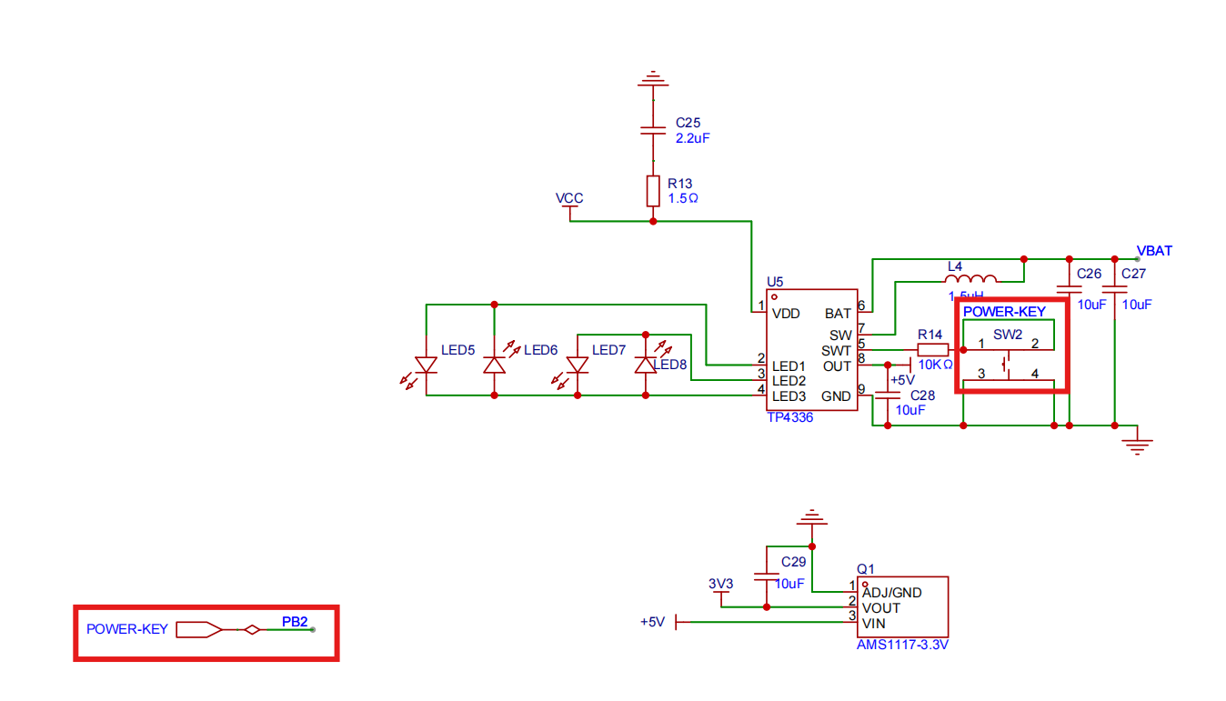
[picture p18: figure]

PB2配置为输出模式才可以驱动电平控制POWER-KEYA按键，默认高电平断开按键

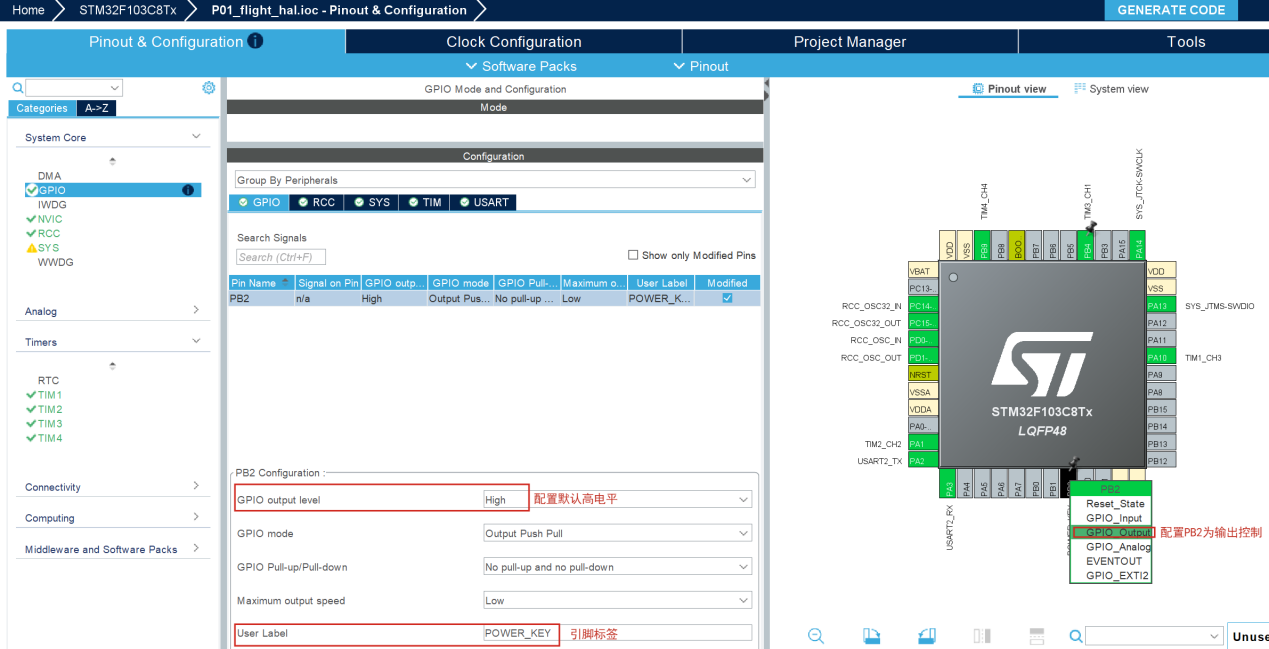
[picture p19: figure]

# 电机控制模块

## 一.配置CubeMX

电机原理图引脚分布

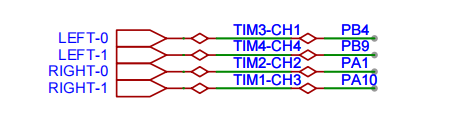
[picture p20: figure]

根据引脚配置定时器参数

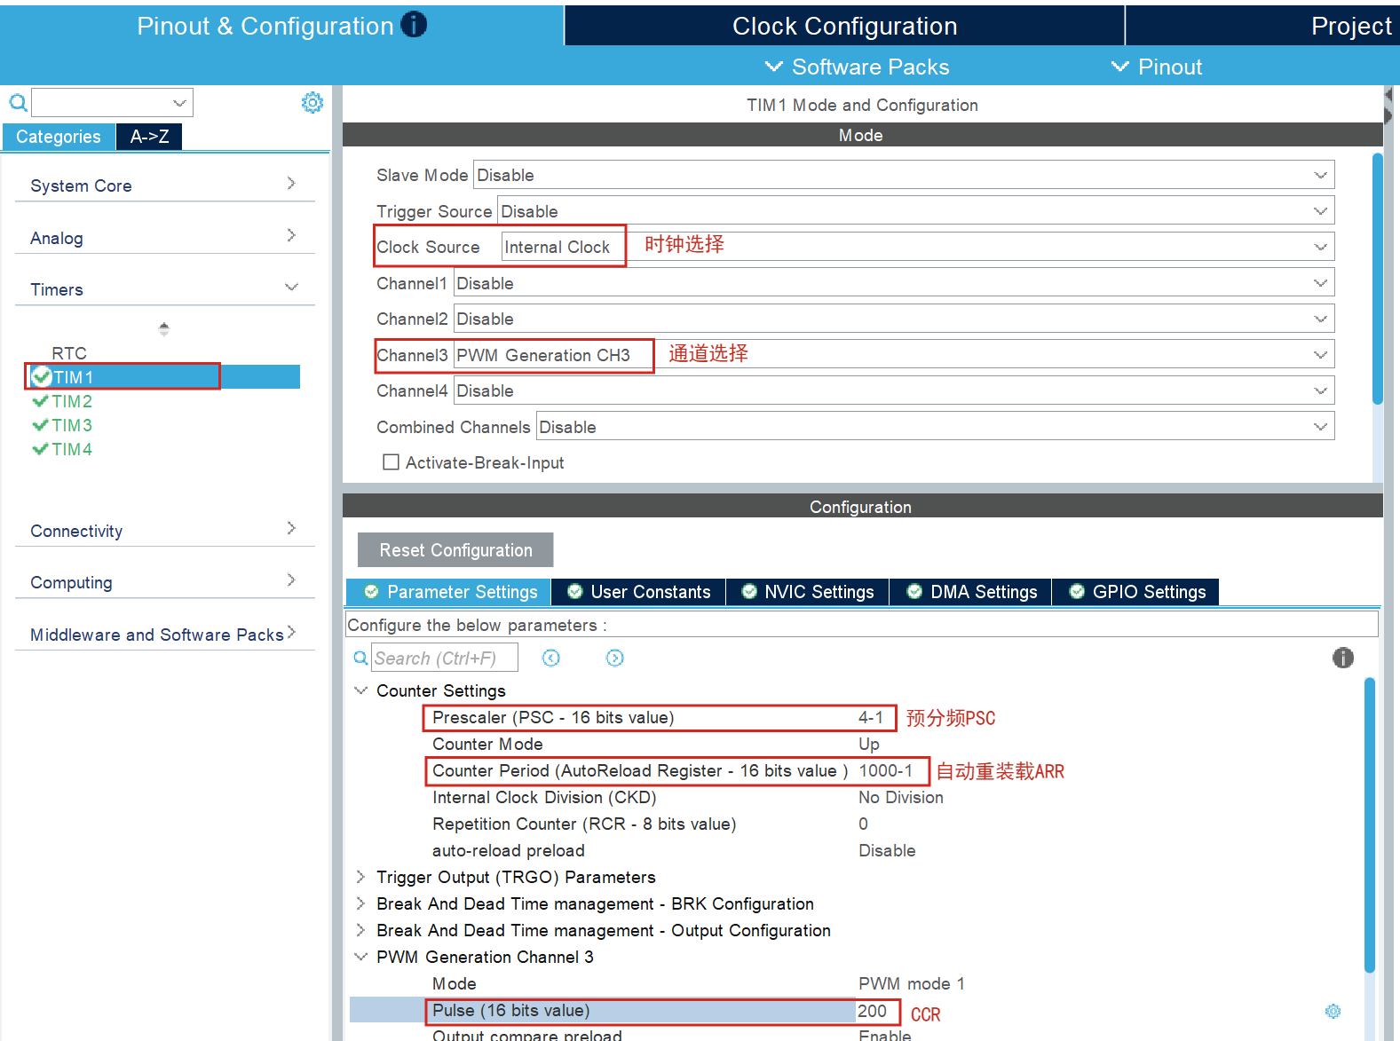
[picture p21: figure]

其它定时器除了通道选择不同，其它参数相同。Tim3定时器的引脚根据原理图要重定向到PB4引脚

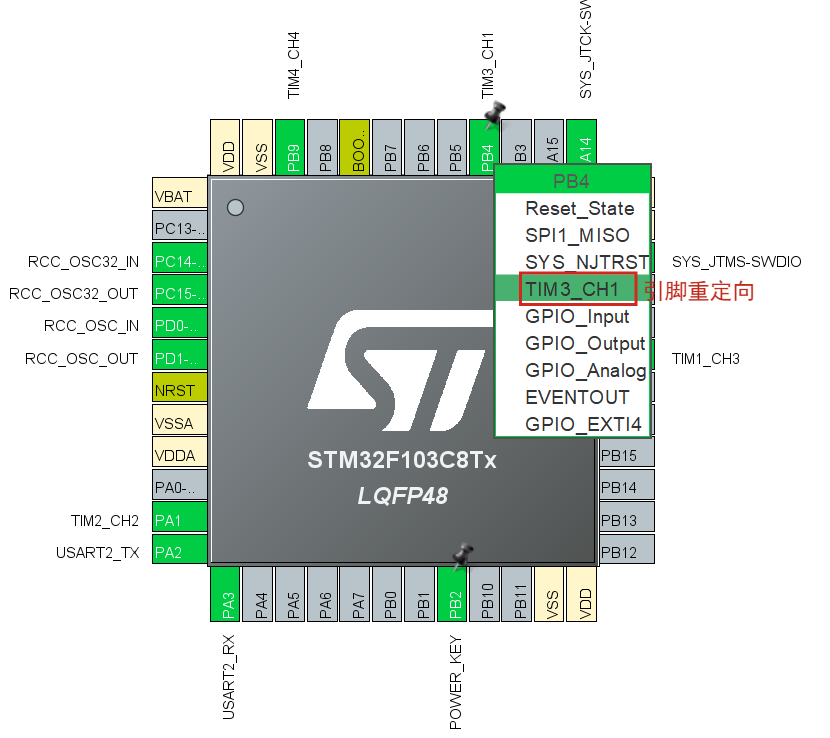
[picture p22: figure]

# LED灯模块

## 配置CubeMX

  电机原理图引脚分布

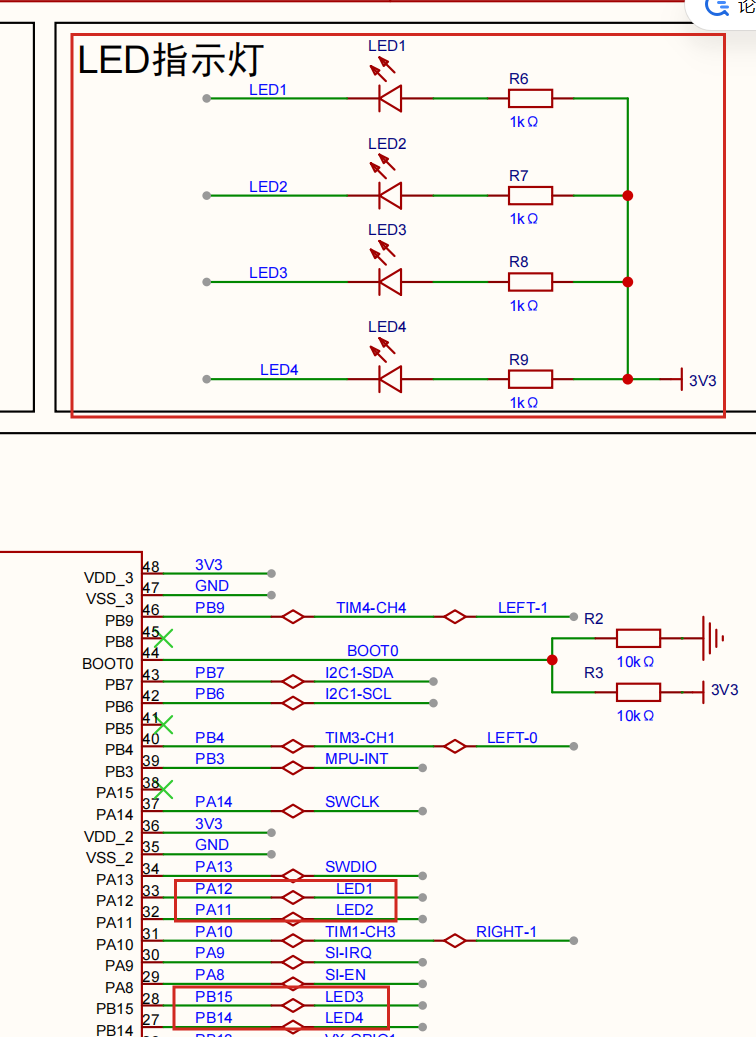
[picture p23: figure]

根据PB12、PB13、PB14、PB15引脚配置参数

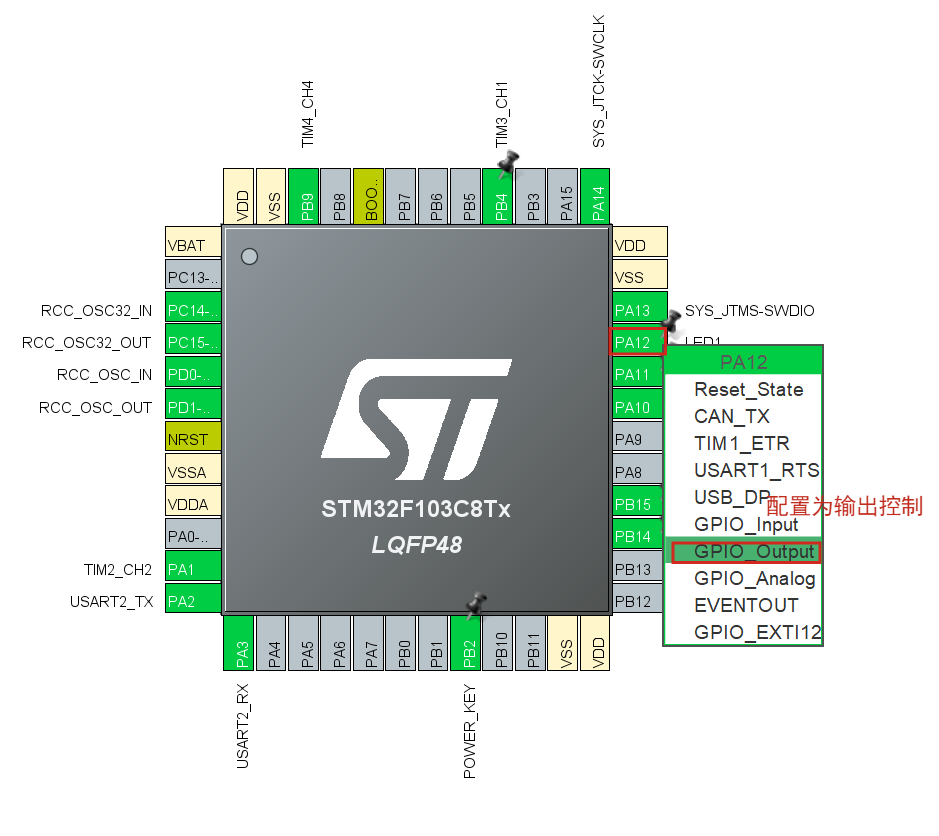
[picture p24: figure]
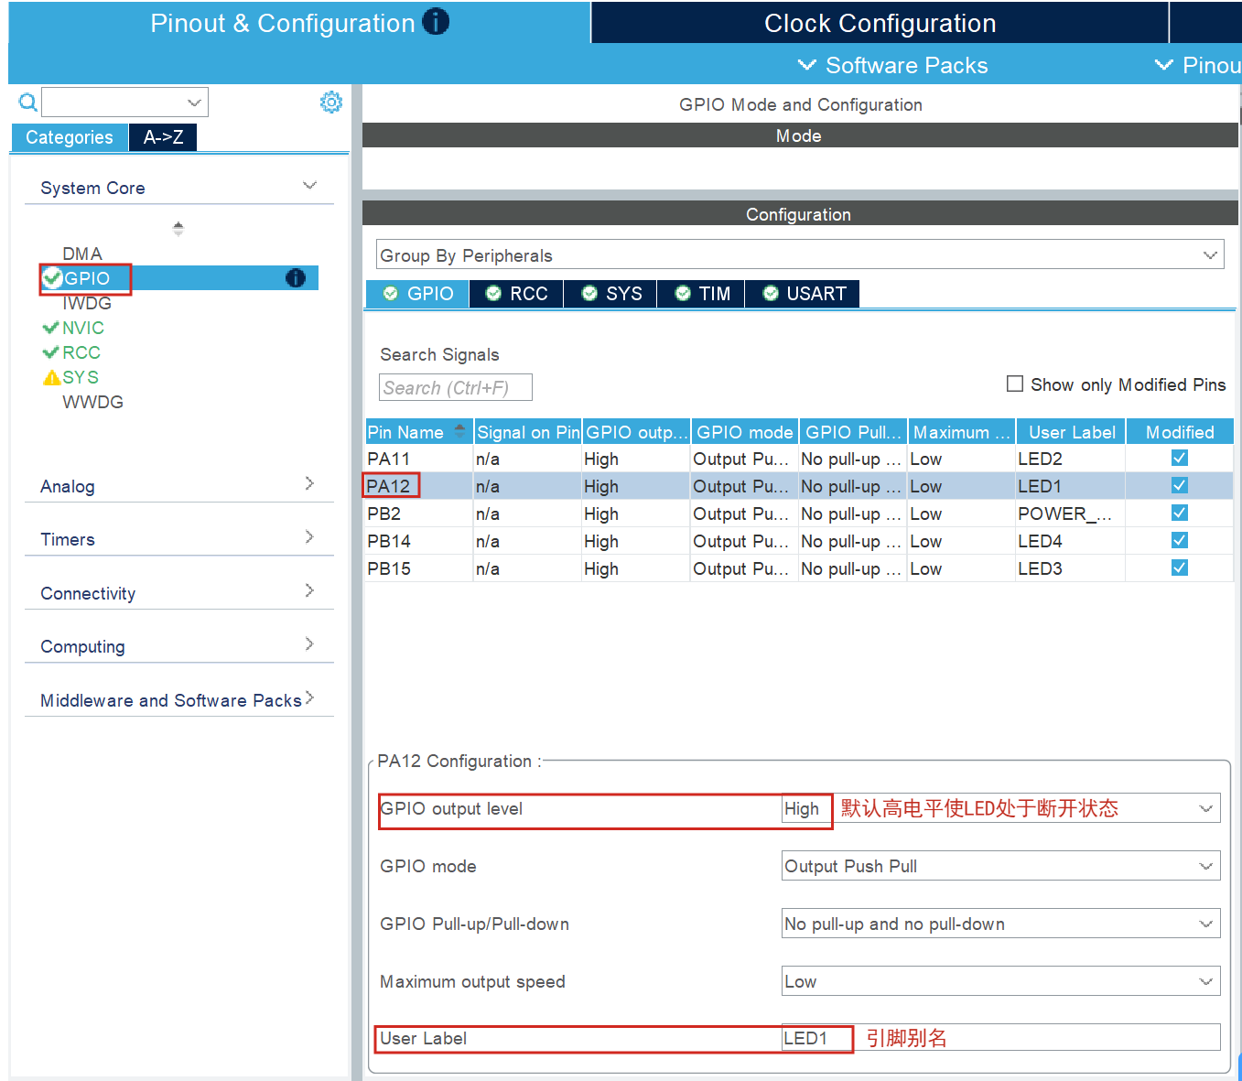
[picture p25: figure]

# 2.4G无线通信模块

## 配置CubeMX

  电机原理图引脚分布

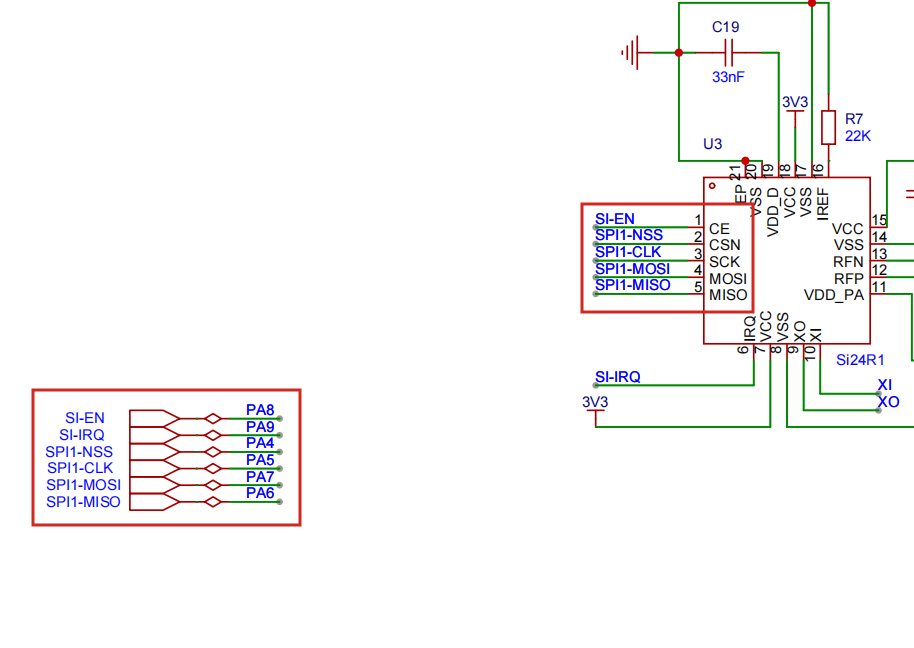
[picture p26: figure]

配置硬件SPI

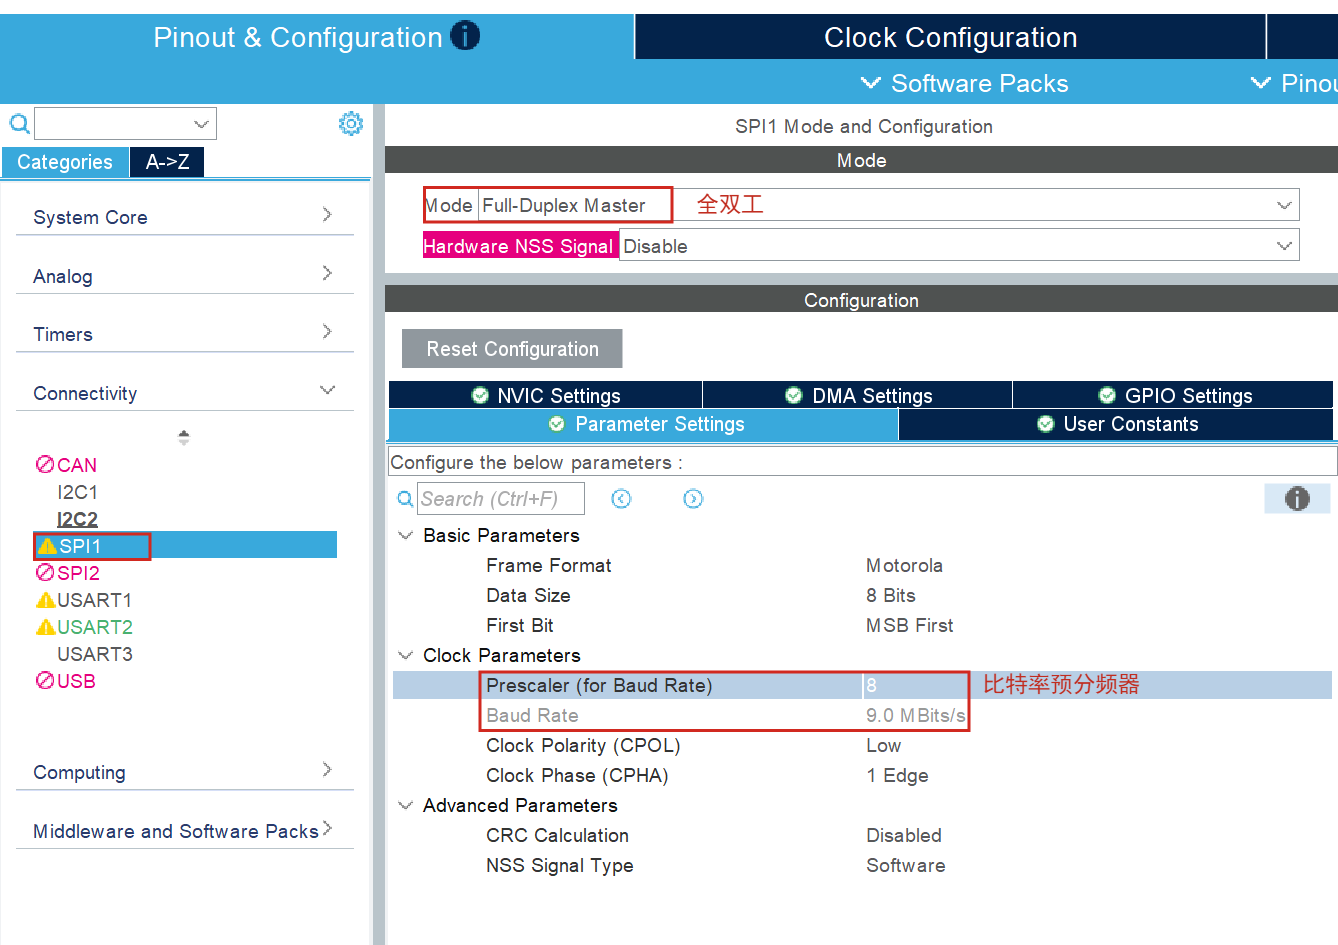
[picture p27: figure]

完成硬件SPI1对应的配置后PA5，PA6，PA7引脚自动配置完成

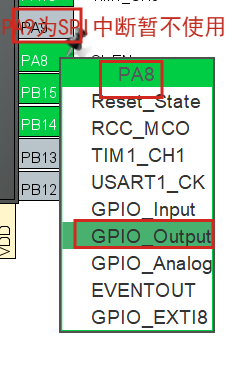
[picture p28: figure]
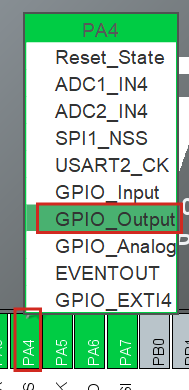
[picture p29: figure]
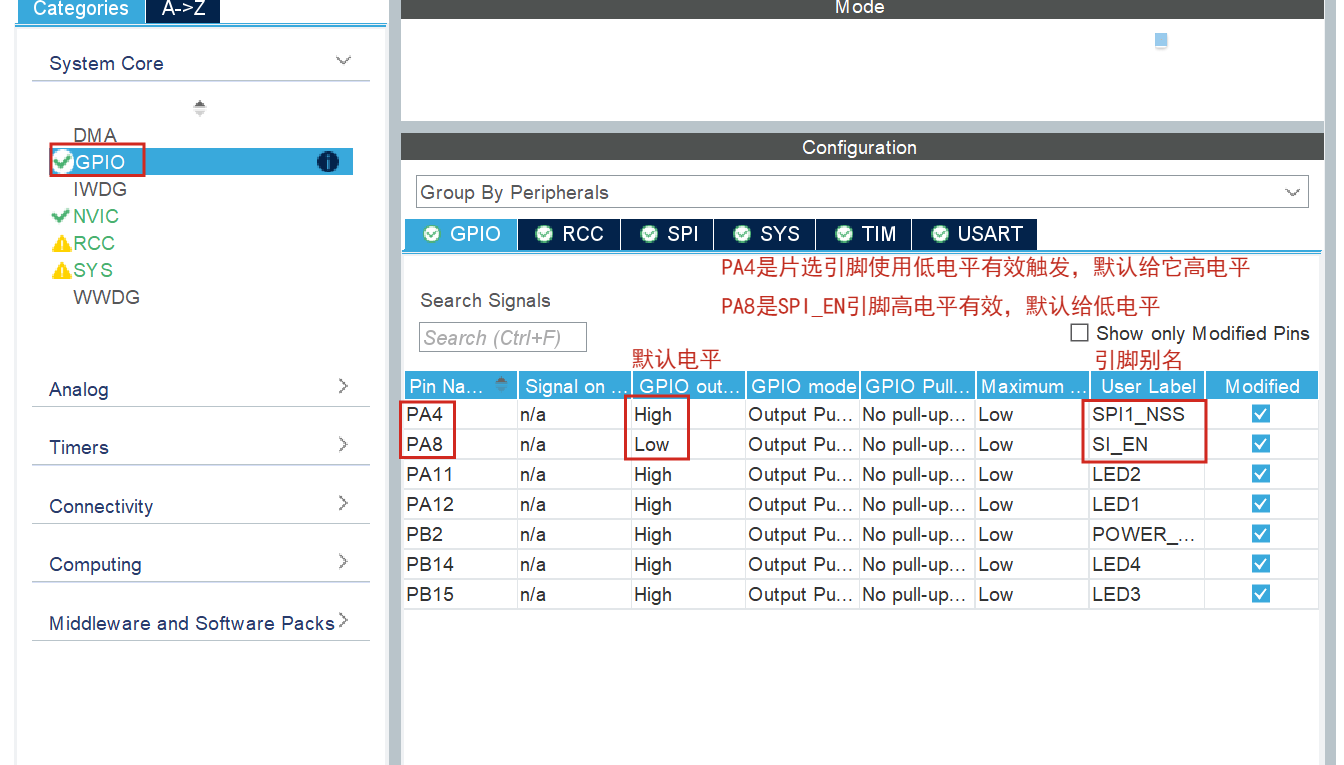
[picture p30: figure]

# 遥控器按键模块

## 配置CubeMX

  遥控器按键引脚分布

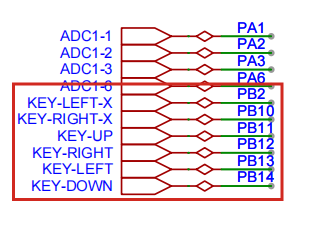
[picture p31: figure]
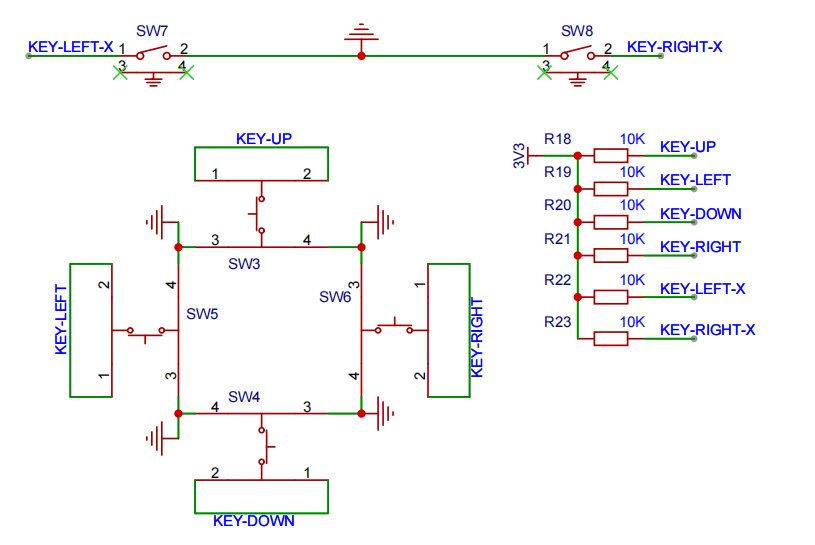
[picture p32: figure]

配置对应引脚

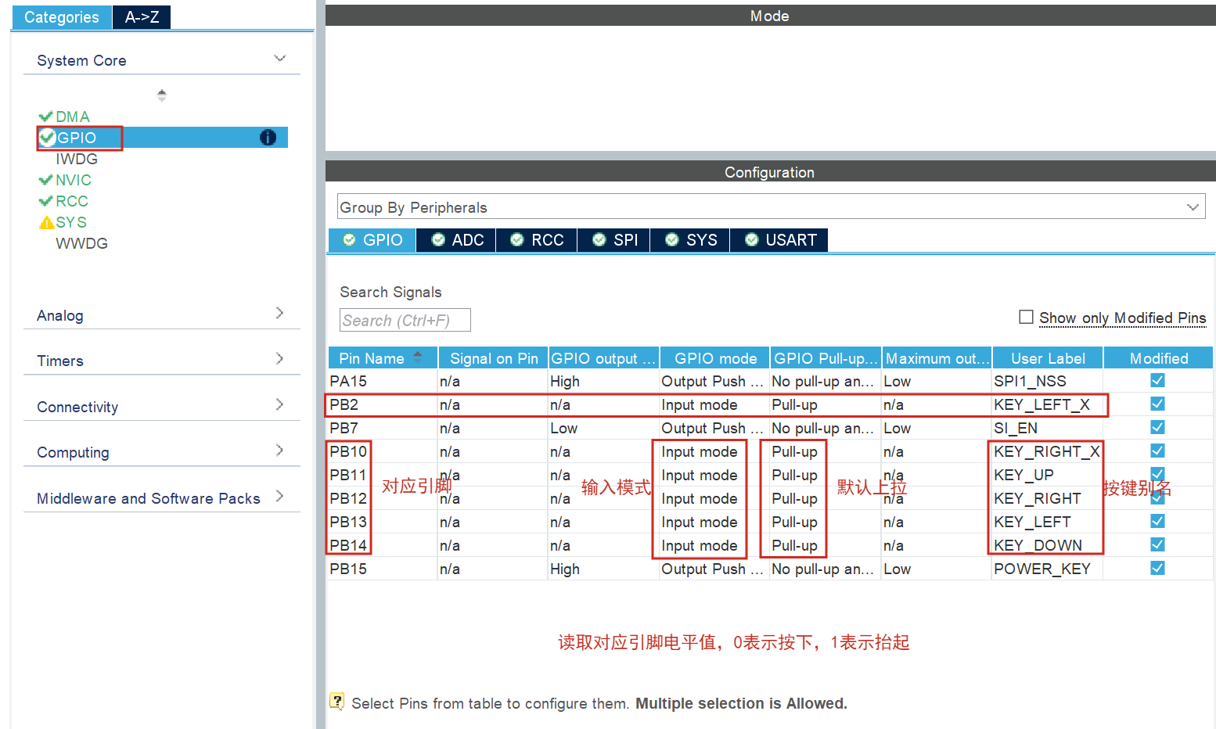
[picture p33: figure]

# 遥控器摇杆ADC模块

## 配置CubeMX

  遥控器摇杆ADC引脚分布

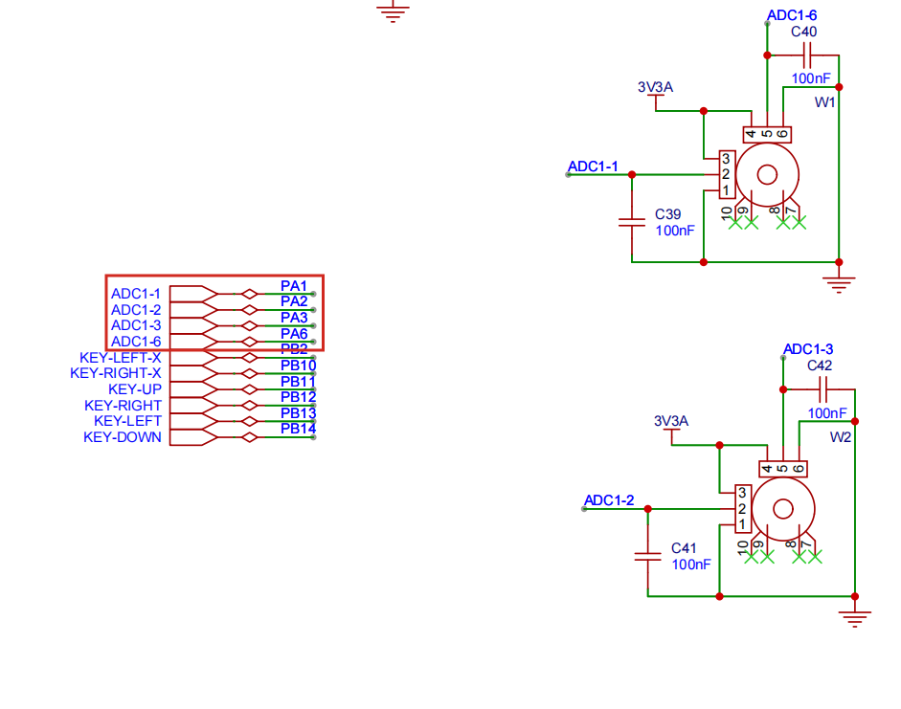
[picture p34: figure]

配置对应引脚

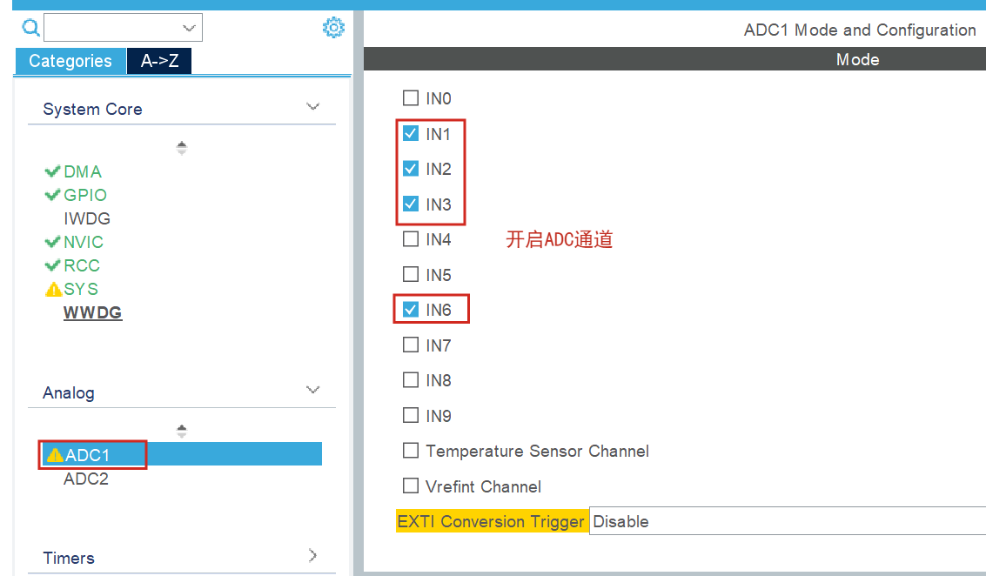
[picture p35: figure]
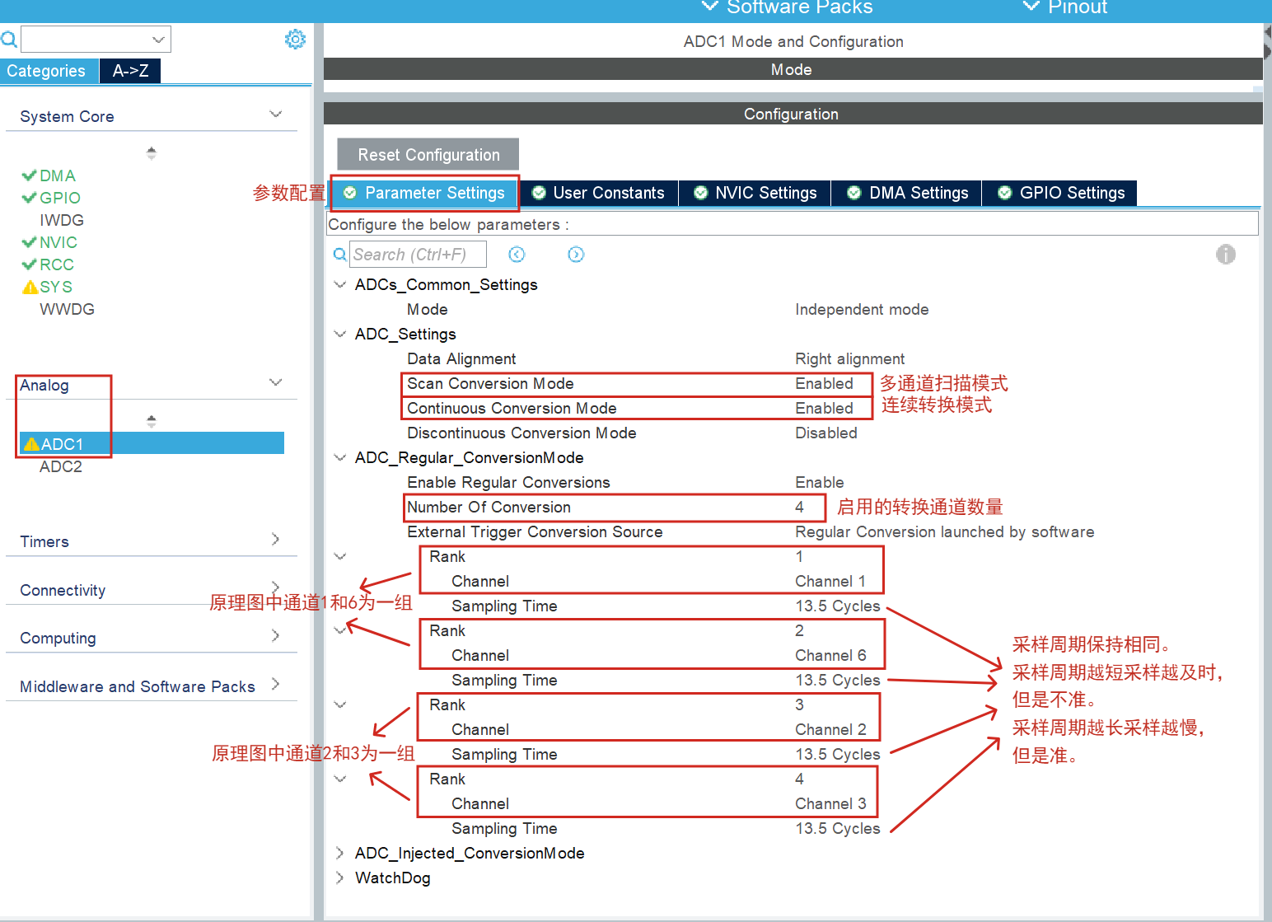
[picture p36: figure]
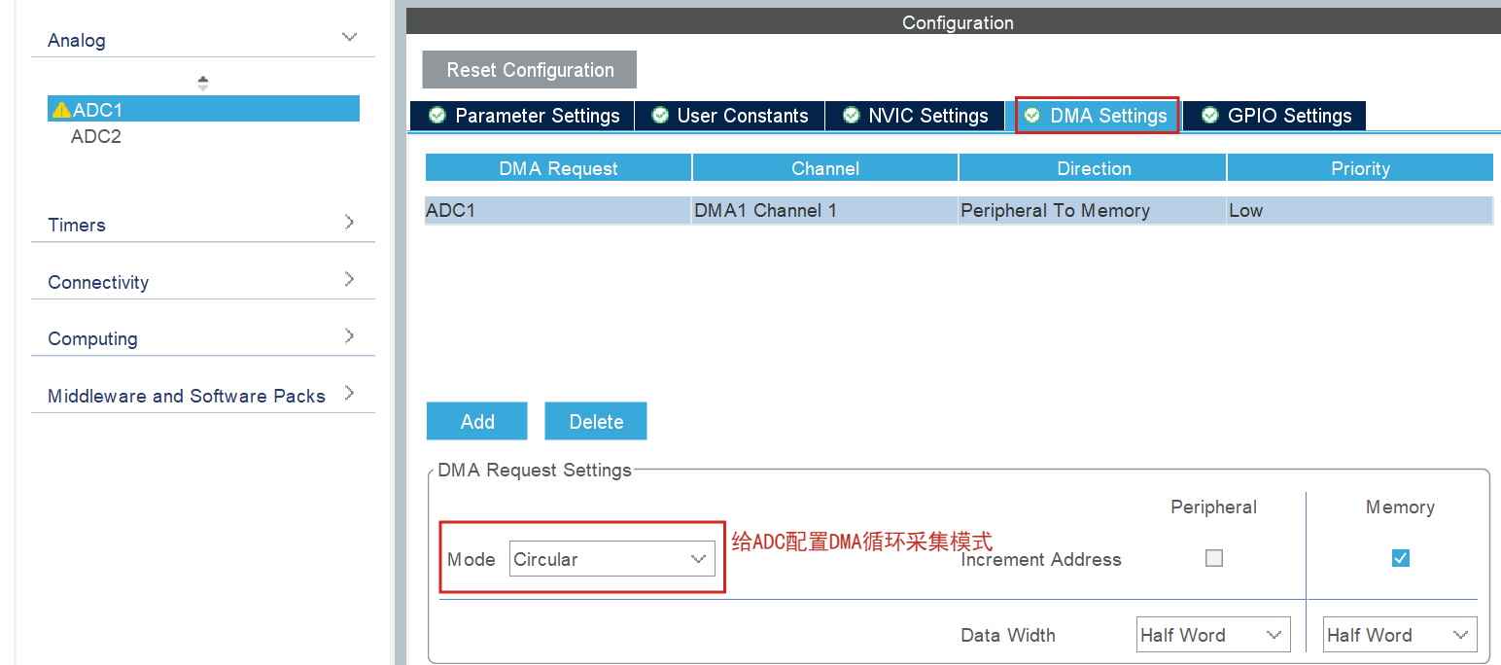
[picture p37: figure]
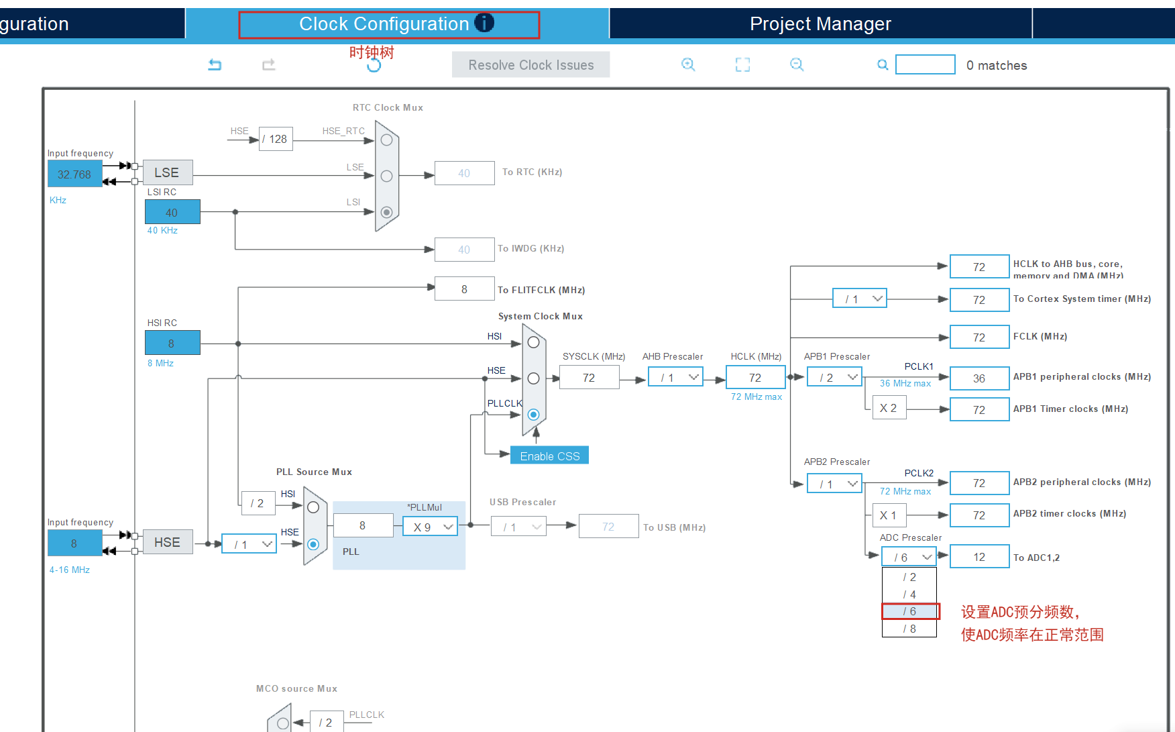
[picture p38: figure]

# MPU6050模块

## 配置CubeMX

  原理图引脚分布

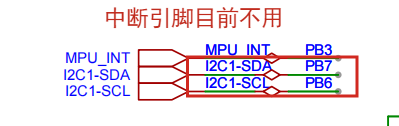
[picture p39: figure]

配置对应引脚

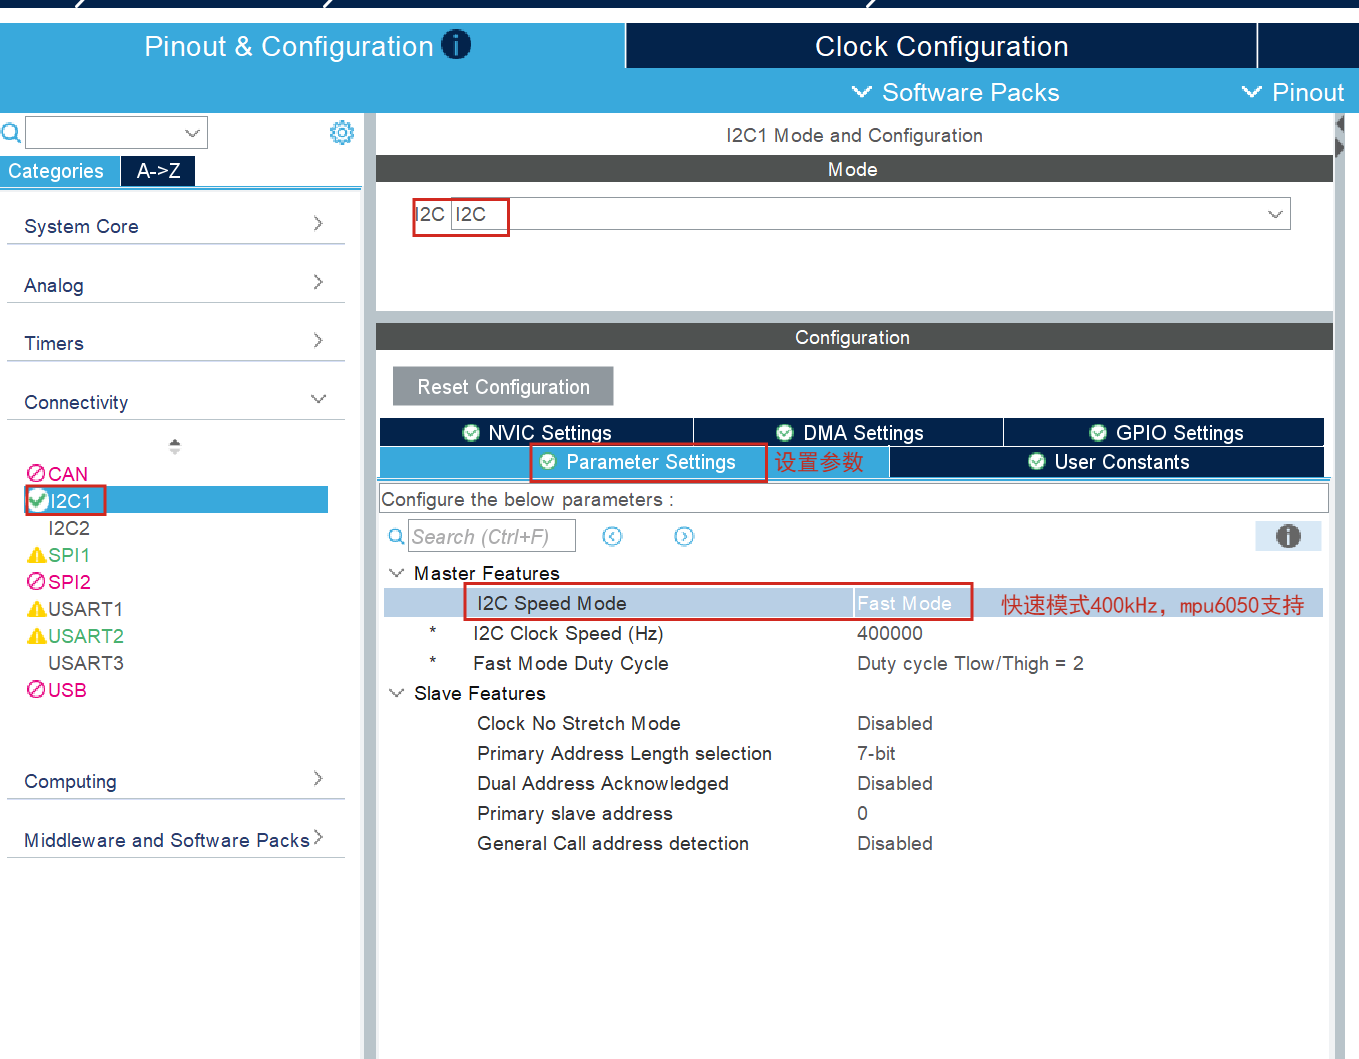
[picture p40: figure]

# 激光测距模块

## 配置CubeMX

  原理图引脚分布

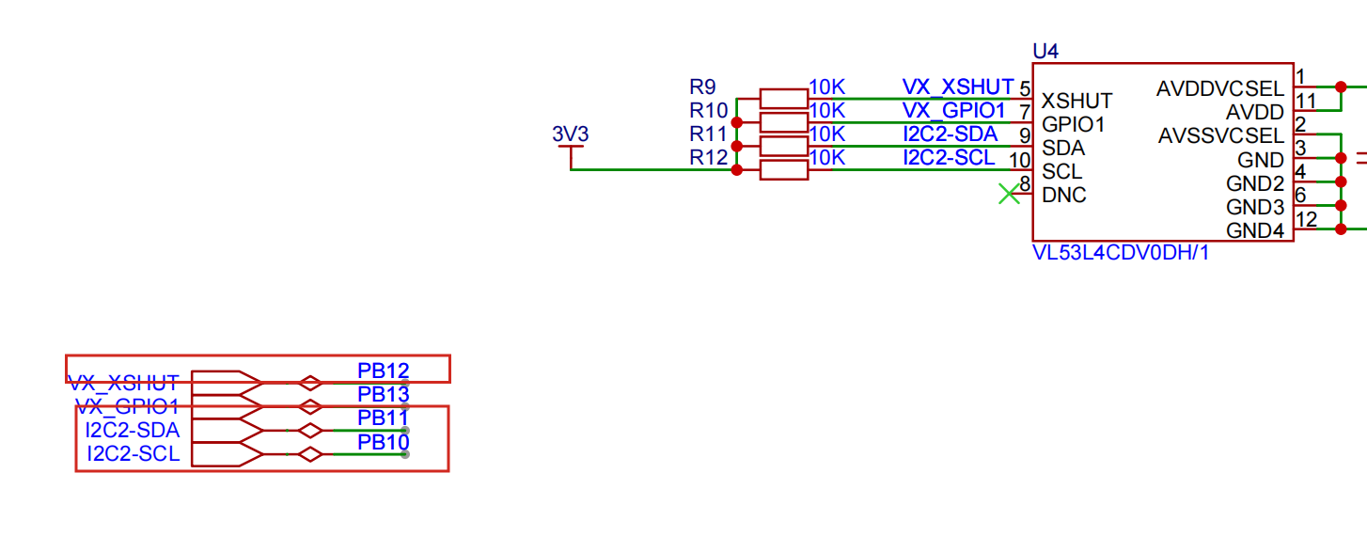
[picture p41: figure]

配置对应引脚

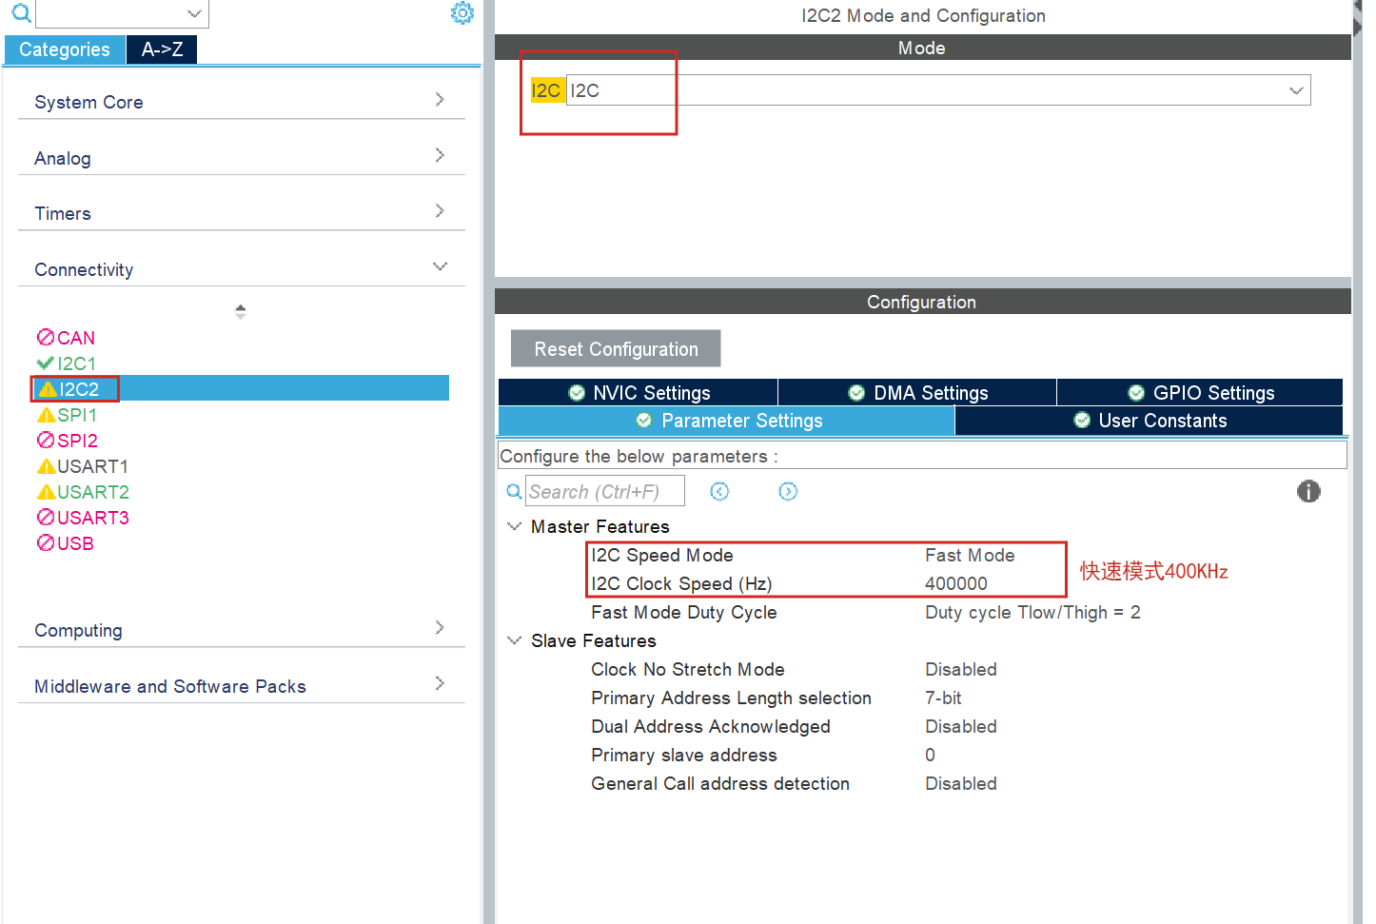
[picture p42: figure]
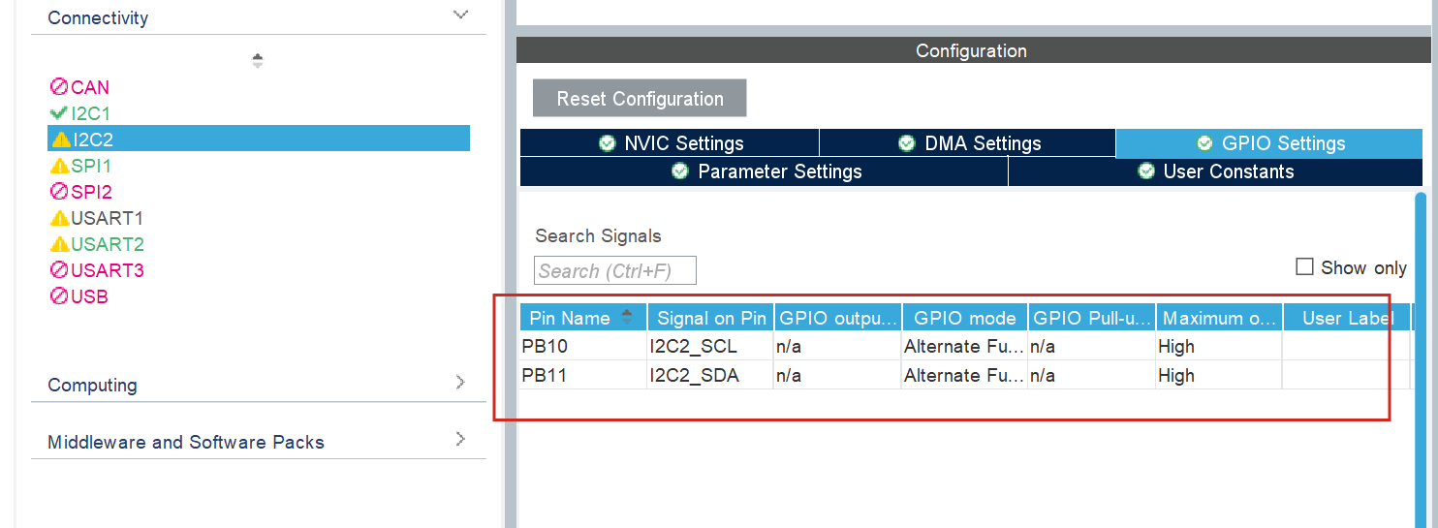
[picture p43: figure]
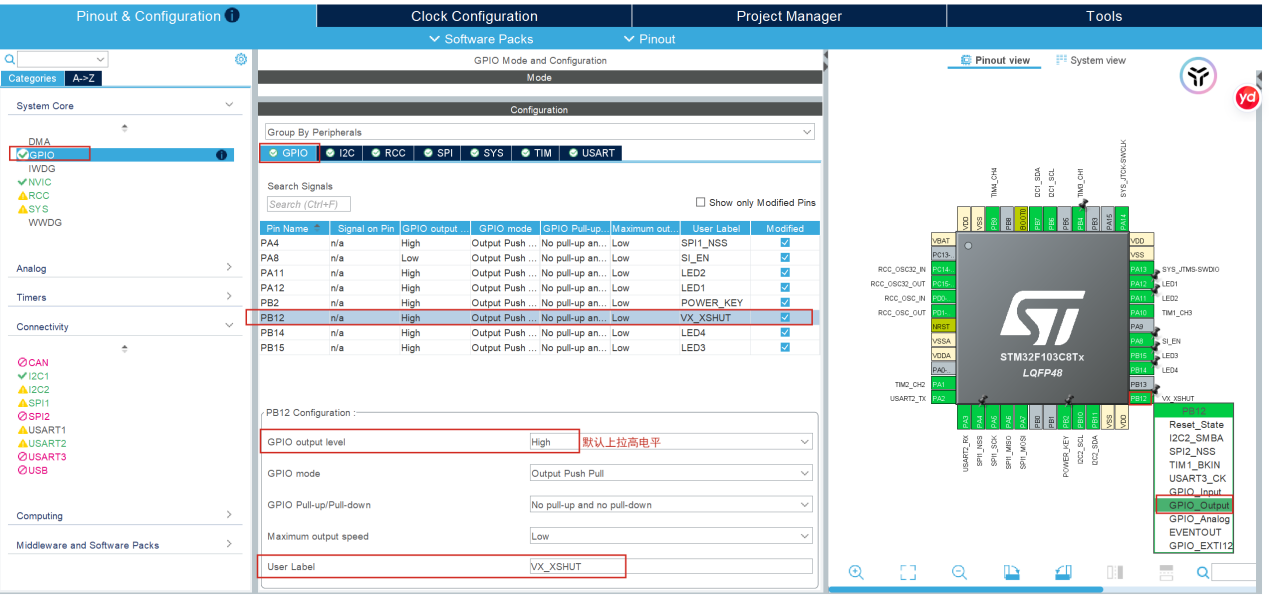
[picture p44: figure]
