lizhigang34098/FreeRTOS_UAV/Project_Step_Analysis/14.遥控屏幕显示.docx

## 1.1 Interface/oled

## 1.2 App_display.h

### #ifndef __APP_DISPLAY__

### #define __APP_DISPLAY__

### #include "Inf_OLED.h"

### #include "Int_SI24R1.h"

### #include "App_process_data.h"

### #define LINE1_BEGIN 28

### #define LINE2_BEGIN 5

### #define LINE3_BEGIN 5

### #define LINE4_BEGIN 5

### #define BAR1_BEGING 35

### #define BAR2_BEGING 47

### #define LINE3_BEGIN2 65

### #define BAR1_BEGING2 95

### #define BAR2_BEGING2 107

### #define LINE4_BEGIN2 65

### #define Y0 0

### #define Y1 14

### #define Y2 26

### #define Y3 38

### /**

### * @brief 初始化显示模块

### *

### */

### void App_display_init(void);

### /**

### * @brief 循环执行刷写屏幕

### *

### */

### void App_display_show(void);

### #endif // __APP_DISPLAY__

## 1.3 App_display.c

### #include "App_display.h"

### extern Remote_Data remote_data;

### // 回传的电压值

### extern uint8_t post_buff[TX_PLOAD_WIDTH];

### void App_display_show_bar(uint8_t x, uint8_t y, uint8_t count)

### {

### if (count < 13)

### {

### OLED_Show_CH(x, y, 12 + count, 12, 1);

### }

### }

### /**

### * @brief 初始化显示模块

### *

### */

### void App_display_init(void)

### {

### OLED_Init();

### }

### /**

### * @brief 循环执行刷写屏幕

### *

### */

### void App_display_show(void)

### {

### // 将显示内容写入到缓存

### // (1) X坐标 (2) Y坐标 (3)字符串 (4) 字体大小 (5) 模式(字白底黑)

### // OLED_ShowString(0, 0, "Hello World", 12, 1);

### // 第一行 => 标题 尚硅谷嵌入式

### for (uint8_t i = 0; i < 6; i++)

### {

### OLED_Show_CH(LINE1_BEGIN + 12 * i, Y0, i, 12, 1);

### }

### // 第二行 => 展示2.4G通信的信道

### uint8_t buff[3] = {0};

### sprintf((char *)buff, "%03d", CHANNEL);

### OLED_ShowString(LINE2_BEGIN, Y1, buff, 12, 1);

### // 第二行 => 右边显示回传的电压值 => 推算出剩余的电量

### OLED_ShowString(LINE2_BEGIN + 64, Y1, "V: ", 12, 1);

### OLED_ShowString(LINE2_BEGIN + 88, Y1, post_buff, 12, 1);

### uint8_t count = 0;

### // 第三行 => 展示遥控数据 THR ROL

### OLED_ShowString(LINE3_BEGIN, Y2, "THR:", 12, 1);

### if (remote_data.thr > 500)

### {

### count = (remote_data.thr - 500) / 41;

### // 前一个汉字字符 涂满

### App_display_show_bar(BAR1_BEGING, Y2, 12);

### App_display_show_bar(BAR2_BEGING, Y2, count);

### }

### else

### {

### count = (remote_data.thr) / 41;

### // 只图前一个字符 后一个图空白

### App_display_show_bar(BAR1_BEGING, Y2, count);

### App_display_show_bar(BAR2_BEGING, Y2, 0);

### }

### OLED_ShowString(LINE3_BEGIN2, Y2, "ROL:", 12, 1);

### if (remote_data.rol > 500)

### {

### count = (remote_data.rol - 500) / 41;

### // 前一个汉字字符 涂满

### App_display_show_bar(BAR1_BEGING2, Y2, 12);

### App_display_show_bar(BAR2_BEGING2, Y2, count);

### }

### else

### {

### count = (remote_data.rol) / 41;

### // 只图前一个字符 后一个图空白

### App_display_show_bar(BAR1_BEGING2, Y2, count);

### App_display_show_bar(BAR2_BEGING2, Y2, 0);

### }

### // 第四行 => YAW PIT

### OLED_ShowString(LINE4_BEGIN, Y3, "YAW:", 12, 1);

### if (remote_data.yaw > 500)

### {

### count = (remote_data.yaw - 500) / 41;

### // 前一个汉字字符 涂满

### App_display_show_bar(BAR1_BEGING, Y3, 12);

### App_display_show_bar(BAR2_BEGING, Y3, count);

### }

### else

### {

### count = (remote_data.yaw) / 41;

### // 只图前一个字符 后一个图空白

### App_display_show_bar(BAR1_BEGING, Y3, count);

### App_display_show_bar(BAR2_BEGING, Y3, 0);

### }

### OLED_ShowString(LINE4_BEGIN2, Y3, "PIT:", 12, 1);

### if (remote_data.pit > 500)

### {

### count = (remote_data.pit - 500) / 41;

### // 前一个汉字字符 涂满

### App_display_show_bar(BAR1_BEGING2, Y3, 12);

### App_display_show_bar(BAR2_BEGING2, Y3, count);

### }

### else

### {

### count = (remote_data.pit) / 41;

### // 只图前一个字符 后一个图空白

### App_display_show_bar(BAR1_BEGING2, Y3, count);

### App_display_show_bar(BAR2_BEGING2, Y3, 0);

### }

### // 调用刷写才能真的显示

### OLED_Refresh_Gram();

### }

## 1.4 App_freeRTOS_Task.c

### #include "App_freeRTOS_Task.h"

### // 屏幕任务

### void oled_task(void *args);

### #define OLED_TASK_STACK_SIZE 128

### #define OLED_TASK_PRIORITY 1

### TaskHandle_t oled_task_handle;

### #define OLED_TASK_PERIOD 100

### /**

### * @brief 启动freeRTOS操作系统

### *

### */

### void App_freeRTOS_start(void)

### {

### // 屏幕任务

### xTaskCreate(oled_task, "oled_task", OLED_TASK_STACK_SIZE, NULL, OLED_TASK_PRIORITY, &oled_task_handle);

### // 启动调度器

### vTaskStartScheduler();

### }

### void oled_task(void *args)

### {

### TickType_t xLastWakeTime = xTaskGetTickCount();

### App_display_init();

### while (1)

### {

### App_display_show();

### vTaskDelayUntil(&xLastWakeTime, OLED_TASK_PERIOD);

### }

### }
