lizhigang34098/FreeRTOS_UAV/Project_Step_Analysis/15.电量回传.docx

# 第 1 章 飞控

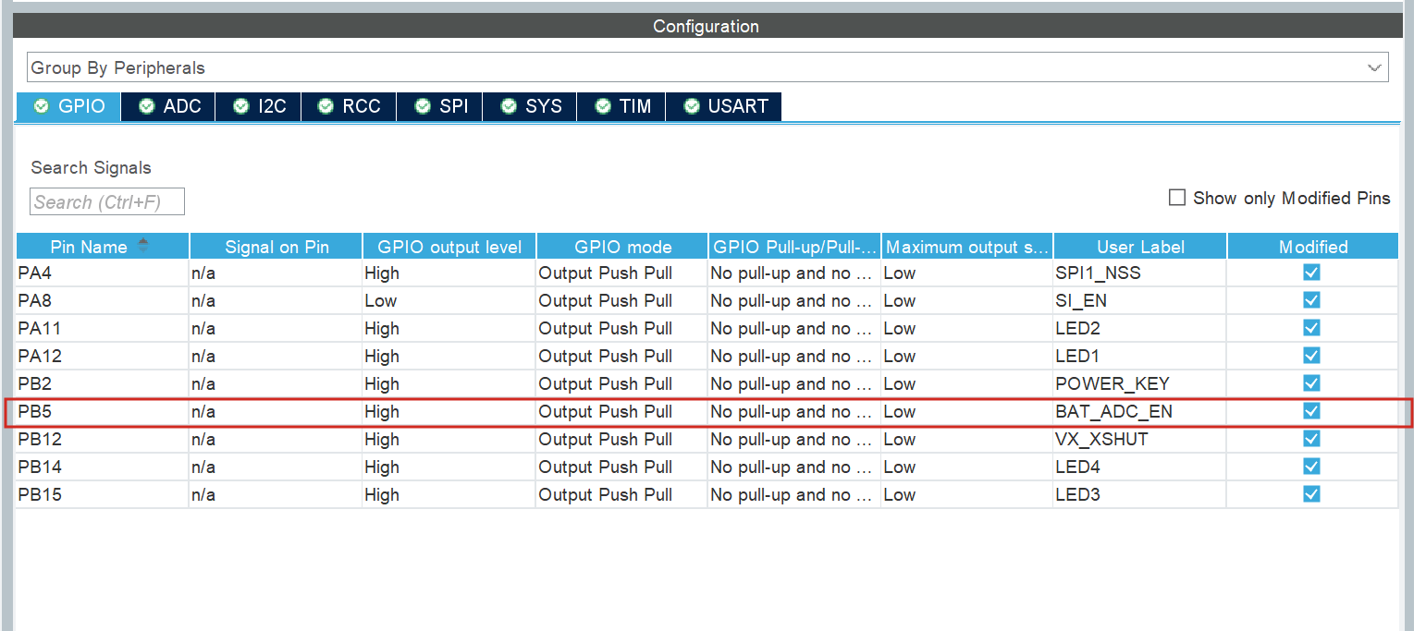
[picture p45: figure]
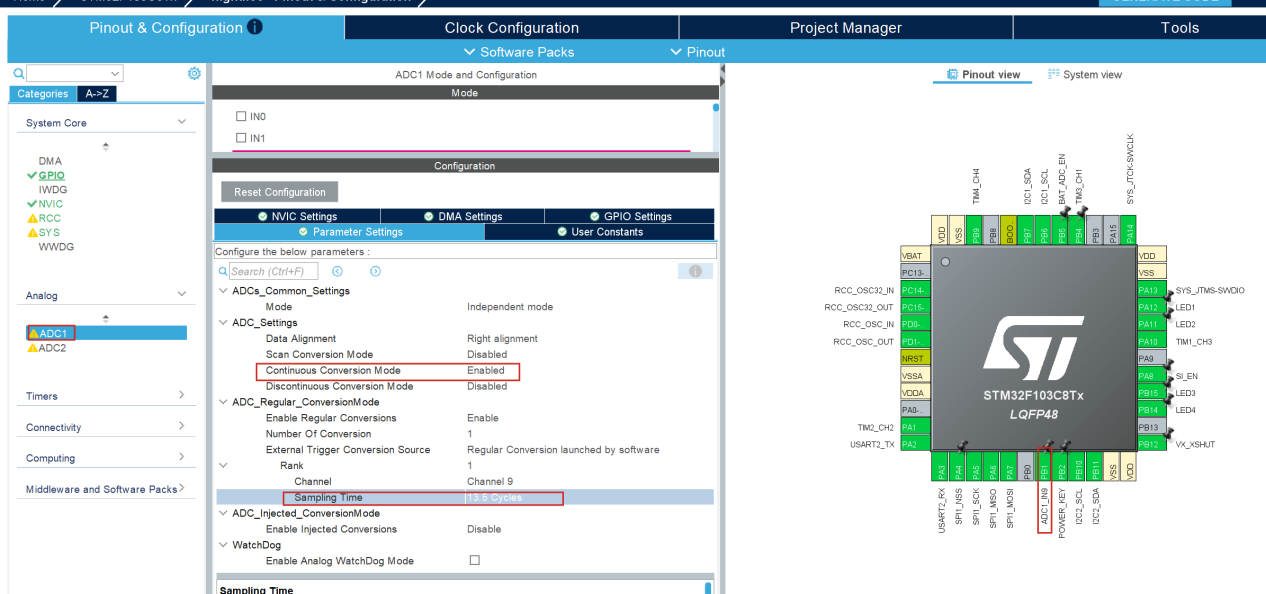
[picture p46: figure]
