lizhigang34098/FreeRTOS_UAV/Project_Step_Analysis/6.遥控按键.docx

## 1.1 Int_key.h

#ifndef __INT_KEY__

#define __INT_KEY__

#include "main.h"

#include "FreeRTOS.h"

#include "task.h"

typedef enum

{

KEY_NONE = 0,

KEY_UP,

KEY_DOWN,

KEY_LEFT,

KEY_RIGHT,

KEY_LEFT_X,

KEY_RIGHT_X,

KEY_RIGHT_X_LONG,

}Key_type;

/**

* @brief 获取当前按键是否被按下

* @return Key_type KEY_NONE:没有按键按下 其他都是对应被按键的标记

*/

Key_type Int_key_get(void);

#endif // __INT_KEY__

## 1.2 Int_key.c

### #include "Int_key.h"

### /**

### * @brief 获取当前按键是否被按下

### * @return Key_type KEY_NONE:没有按键按下 其他都是对应被按键的标记

### */

### Key_type Int_key_get(void)

### {

### if (HAL_GPIO_ReadPin(KEY_UP_GPIO_Port, KEY_UP_Pin) == GPIO_PIN_RESET)

### {

### // 1. 电弧抖动 => 需要进行消抖

### vTaskDelay(5);

### if (HAL_GPIO_ReadPin(KEY_UP_GPIO_Port, KEY_UP_Pin) == GPIO_PIN_RESET)

### {

### // 2. 人按下的时间通常比较长 => 为了不被多次判断 => 等待抬起按键才返回

### while (HAL_GPIO_ReadPin(KEY_UP_GPIO_Port, KEY_UP_Pin) == GPIO_PIN_RESET)

### {vTaskDelay(1);}

### // KEY_UP被按下

### return KEY_UP;

### }

### }

### else if (HAL_GPIO_ReadPin(KEY_DOWN_GPIO_Port, KEY_DOWN_Pin) == GPIO_PIN_RESET)

### {

### // 1. 电弧抖动 => 需要进行消抖

### vTaskDelay(5);

### if (HAL_GPIO_ReadPin(KEY_DOWN_GPIO_Port, KEY_DOWN_Pin) == GPIO_PIN_RESET)

### {

### // 2. 人按下的时间通常比较长 => 为了不被多次判断 => 等待抬起按键才返回

### while (HAL_GPIO_ReadPin(KEY_DOWN_GPIO_Port, KEY_DOWN_Pin) == GPIO_PIN_RESET)

### {vTaskDelay(1);}

### // KEY_DOWN被按下

### return KEY_DOWN;

### }

### }

### else if (HAL_GPIO_ReadPin(KEY_LEFT_GPIO_Port, KEY_LEFT_Pin) == GPIO_PIN_RESET)

### {

### // 1. 电弧抖动 => 需要进行消抖

### vTaskDelay(5);

### if (HAL_GPIO_ReadPin(KEY_LEFT_GPIO_Port, KEY_LEFT_Pin) == GPIO_PIN_RESET)

### {

### // 2. 人按下的时间通常比较长 => 为了不被多次判断 => 等待抬起按键才返回

### while (HAL_GPIO_ReadPin(KEY_LEFT_GPIO_Port, KEY_LEFT_Pin) == GPIO_PIN_RESET)

### {vTaskDelay(1);}

### // KEY_LEFT被按下

### return KEY_LEFT;

### }

### }

### else if (HAL_GPIO_ReadPin(KEY_RIGHT_GPIO_Port, KEY_RIGHT_Pin) == GPIO_PIN_RESET)

### {

### // 1. 电弧抖动 => 需要进行消抖

### vTaskDelay(5);

### if (HAL_GPIO_ReadPin(KEY_RIGHT_GPIO_Port, KEY_RIGHT_Pin) == GPIO_PIN_RESET)

### {

### // 2. 人按下的时间通常比较长 => 为了不被多次判断 => 等待抬起按键才返回

### while (HAL_GPIO_ReadPin(KEY_RIGHT_GPIO_Port, KEY_RIGHT_Pin) == GPIO_PIN_RESET)

### {vTaskDelay(1);}

### // KEY_RIGHT被按下

### return KEY_RIGHT;

### }

### }

### // 左上按键

### else if (HAL_GPIO_ReadPin(KEY_LEFT_X_GPIO_Port, KEY_LEFT_X_Pin) == GPIO_PIN_RESET)

### {

### // 1. 电弧抖动 => 需要进行消抖

### vTaskDelay(5);

### if (HAL_GPIO_ReadPin(KEY_LEFT_X_GPIO_Port, KEY_LEFT_X_Pin) == GPIO_PIN_RESET)

### {

### // 2. 人按下的时间通常比较长 => 为了不被多次判断 => 等待抬起按键才返回

### while (HAL_GPIO_ReadPin(KEY_LEFT_X_GPIO_Port, KEY_LEFT_X_Pin) == GPIO_PIN_RESET)

### {vTaskDelay(1);}

### // 左上按键被按下

### return KEY_LEFT_X;

### }

### }

### // 右上按键

### else if (HAL_GPIO_ReadPin(KEY_RIGHT_X_GPIO_Port, KEY_RIGHT_X_Pin) == GPIO_PIN_RESET)

### {

### // 此时开始计时 => 长按为超过1s

### TickType_t count1 = xTaskGetTickCount();

### // 1. 电弧抖动 => 需要进行消抖

### vTaskDelay(5);

### if (HAL_GPIO_ReadPin(KEY_RIGHT_X_GPIO_Port, KEY_RIGHT_X_Pin) == GPIO_PIN_RESET)

### {

### // 被人按下 不是电弧抖动

### while (HAL_GPIO_ReadPin(KEY_RIGHT_X_GPIO_Port, KEY_RIGHT_X_Pin) == GPIO_PIN_RESET)

### {

### // 1ms的时间 cpu是释放的

### vTaskDelay(1);

### }

### TickType_t count2 = xTaskGetTickCount();

### if (count2 - count1 > 1000)

### {

### return KEY_RIGHT_X_LONG;

### }

### else

### {

### return KEY_RIGHT_X;

### }

### }

### }

### // 没有按键按下

### return KEY_NONE;

### }

## 1.3 App_freeRTOS_Task.c

#include "App_freeRTOS_Task.h"

// 按键任务

void key_task(void *args);

#define KEY_TASK_STACK_SIZE 128

#define KEY_TASK_PRIORITY 2

TaskHandle_t key_task_handle;

// 任务周期

#define KEY_TASK_PERIOD 20

/**

* @brief 启动freeRTOS操作系统

*/

void App_freeRTOS_start(void)

{

// 按键任务

xTaskCreate(key_task, "key_task", KEY_TASK_STACK_SIZE, NULL, KEY_TASK_PRIORITY, &key_task_handle);

// 启动调度器

vTaskStartScheduler();

}

void key_task(void *args)

{

TickType_t xLastWakeTime = xTaskGetTickCount();

while (1)

{

// 统一的处理方式

App_process_key_data();

vTaskDelayUntil(&xLastWakeTime, KEY_TASK_PERIOD);

}

}
