lizhigang34098/FreeRTOS_UAV/Project_Step_Analysis/无人机开发流程.pdf

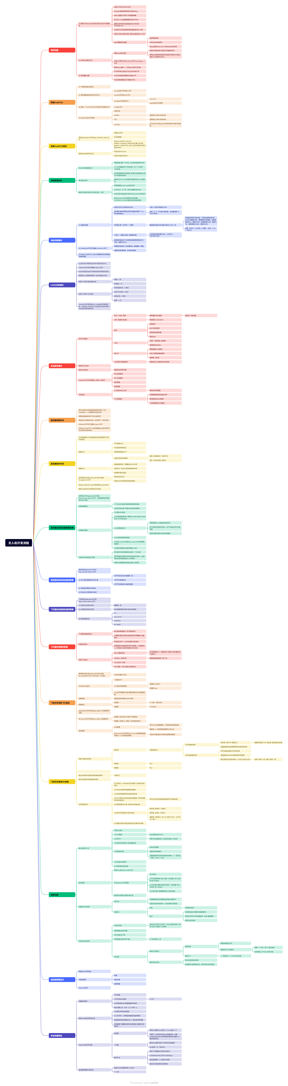
[picture p64: page 1]
