lizhigang34098/FreeRTOS_UAV/flight/flight.ioc

Mcu.UserName=STM32F103C8Tx
PA1.Signal=S_TIM2_CH2
PA10.Signal=S_TIM1_CH3
PA11.GPIO_Label=LED2
PA11.Signal=GPIO_Output
PA12.GPIO_Label=LED1
PA12.Signal=GPIO_Output
PA13.Signal=SYS_JTMS-SWDIO
PA14.Signal=SYS_JTCK-SWCLK
PA2.Signal=USART2_TX
PA3.Signal=USART2_RX
PA4.GPIO_Label=SPI1_NSS
PA4.Signal=GPIO_Output
PA5.Signal=SPI1_SCK
PA6.Signal=SPI1_MISO
PA7.Signal=SPI1_MOSI
PA8.GPIO_Label=SI_EN
PA8.Signal=GPIO_Output
PB1.Signal=ADCx_IN9
PB10.Signal=I2C2_SCL
PB11.Signal=I2C2_SDA
PB12.GPIO_Label=VX_XSHUT
PB12.Signal=GPIO_Output
PB14.GPIO_Label=LED4
PB14.Signal=GPIO_Output
PB15.GPIO_Label=LED3
PB15.Signal=GPIO_Output
PB2.GPIO_Label=POWER_KEY
PB2.Signal=GPIO_Output
PB4.Signal=S_TIM3_CH1
PB5.GPIO_Label=BAT_ADC_EN
PB5.Signal=GPIO_Output
PB6.Signal=I2C1_SCL
PB7.Signal=I2C1_SDA
PB9.Signal=S_TIM4_CH4
PC14-OSC32_IN.Signal=RCC_OSC32_IN
PC15-OSC32_OUT.Signal=RCC_OSC32_OUT
PD0-OSC_IN.Signal=RCC_OSC_IN
PD1-OSC_OUT.Signal=RCC_OSC_OUT
