lizhigang34098/FreeRTOS_UAV/(commit log)

2026-07-21 飞控原理图
2026-08-13 Improve IP5305T driver timing and documentation
2026-08-16 Update frame header, motor driver, and fix typo
    [App_freeRTOS_Task.c, App_receive_data.h]
2026-08-25 Add STM32 flight project and FreeRTOS study notes
    - Add CubeMX-generated flight controller project (Core, HAL drivers, Keil MDK-ARM)
    - Add common module (Com_debug) and custom driver source
    - Add FreeRTOS porting notes and study markdown
    - Update README Com_filter description and 配置操作.docx
    - Exclude unused CMSIS components and Word temp files from git
2026-08-26 Add FreeRTOS integration with task1 demo
    - Add FreeRTOS kernel source under MDK-ARM/freeRTOS
    - Add App_freeRTOS_Task task entry and start scheduler from main
    - Route SysTick to xPortSysTickHandler, remove SVC/PendSV handlers
    - Update project files (uvprojx/uvoptx/ioc)
2026-09-02 add flight MPU6050/filter modules
2026-09-03 add IMU/PID control modules
2026-09-04 update README and add display/battery modules
